emfcamp/badge-2024-hardware/pins-and-bom.ods

Sheet: Pin planning
Device | Configuration | Pin name | Pin number | Special functions | Initial state | Function | Section |  | Hexpansion pins | Function | SFP func |  |  | I2C Addr
ESP |  | 0 | 5 | Bootloader | ext pullup | BL | baseboard |  | 1 | GND | VeeT |  | bus id | BUS | Device | Address | Config | Notes
ESP |  | 1 | 6 |  |  | TOP_HS4 | top | display_cs | 2 | LS_1 | Tx_Fault |  | n/a | ESP | TCA9548PWR | 0x77 | A2/A1/A0=H | May not be used by other devices
ESP |  | 2 | 7 |  |  | TOP_HS3 | top | display_DC | 3 | LS_2 | Tx_Disable |  | BUS7 | SYSTEM | AW9523BTQR A | 0x58 | AD0=L, AD1=L
ESP |  | 3 | 8 |  |  | F_HS1 | F |  | 4 | SDA | SDA |  | BUS7 | SYSTEM | AW9523BTQR B | 0x59 | AD0=H, AD1=L
ESP |  | 4 | 9 |  |  | F_HS2 | F |  | 5 | SCL | SCL |  | BUS7 | SYSTEM | AW9523BTQR C | 0x5a | AD0=L, AD1=H
ESP |  | 5 | 10 |  |  | F_HS3 | F |  | 6 | NoduleDetect | Mod_ABS |  | BUS7 | SYSTEM | BQ25895RTWR | 0x6A | fixed
ESP |  | 6 | 11 |  |  | F_HS4 | F |  | 7 | LS_3 | RS0 |  | BUS7 | SYSTEM | FUSB302MPX | 0x22 | fixed
ESP |  | 7 | 12 |  |  | TOP_HS2 | top | display_data | 8 | LS_4 | Rx_LOS |  | BUS7 | SYSTEM | SC7A20TR | 0x18 | SDO=L
ESP |  | 8 | 13 |  |  | TOP_HS1 | top | display_clk | 9 | LS_5 | RS1 |  | BUS7 | SYSTEM | LSM6DS3TR-C | 0x6B | SDO=H
ESP |  | 9 | 14 |  |  | I2C_RESET | baseboard |  | 10 | GND | VeeR |  | BUS0 | TOP | FUSB302MPX | 0x22 | fixed | not allowed on top board
ESP |  | 10 | 15 |  |  | Interrupt | baseboard |  | 11 | GND | VeeR |  | BUS0 | TOP | ZD24C64A-XGMT | 0x57/0x5f | AD0/1/2=H | required for id/code
ESP |  | 11 | 16 |  |  | D_HS1 | D |  | 12 | HS_1 | RD- |  | BUS1-6 | hexpansion | ZD24C64A-XGMT | 0x57/0x5f | AD0/1/2=H | preferred for id/code
ESP |  | 12 | 17 |  |  | D_HS4 | D |  | 13 | HS_2 | RD+ |  | BUS1-6 | hexpansion | M24C16-RMN6TP | 0x50-0x57 | fixed | allowed for id/code
ESP |  | 13 | 18 |  |  | D_HS3 | D |  | 14 | GND | VeeR
ESP |  | 14 | 19 |  |  | D_HS2 | D |  | 15 | +3V3 | VccR
ESP |  | 15 | 21 |  |  | E_HS3 | E |  | 16 | +3V3 | VccT
ESP |  | 16 | 22 |  |  | E_HS2 | E |  | 17 | GND | VeeT
ESP |  | 17 | 23 |  |  | E_HS4 | E |  | 18 | HS_3 | TD+
ESP |  | 18 | 24 |  |  | E_HS1 | E |  | 19 | HS_4 | TD-
ESP |  | 19 | 25 | USB- |  | USB- | baseboard |  | 20 | GND | VeeT
ESP |  | 20 | 26 | USB+ |  | USB+ | baseboard
ESP |  | 21 | 27 |  |  | LED_DATA | top
ESP |  | 33 | 38 |  |  | C_HS2 | C
ESP |  | 34 | 39 |  |  | C_HS1 | C |  |  | FPC pins |  |  |  |  | SOICBITE pins
ESP |  | 35 | 40 |  |  | B_HS1 | B |  |  | Baseboard | Top | Function |  |  | 1 | GND
ESP |  | 36 | 41 |  |  | B_HS2 | B |  |  | 1 | 30 | GND |  |  | 2 | USB+
ESP |  | 37 | 42 |  |  | B_HS3 | B |  |  | 2 | 29 | LED_DATA |  |  | 3 | USB-
ESP |  | 38 | 43 |  |  | B_HS4 | B |  |  | 3 | 28 | VBAT_SW |  |  | 4 | VBUS
ESP |  | 39 | 44 | tck |  | A_HS1 | A |  |  | 4 | 27 | VBAT_SW |  |  | 5 | ESPRESET
ESP |  | 40 | 45 | tdo |  | A_HS2 | A |  |  | 5 | 26 | GND |  |  | 6 | BOOTLOADER
ESP |  | 41 | 47 | tdi |  | A_HS3 | A |  |  | 6 | 25 | BTN1 |  |  | 7 | ESP_RXD
ESP |  | 42 | 48 | tms |  | A_HS4 | A |  |  | 7 | 24 | BTN2 |  |  | 8 | ESP_TXD
ESP |  | 43 | 49 | TXD |  | TX | baseboard |  |  | 8 | 23 | BTN3
ESP |  | 44 | 50 | RXD |  | RX | baseboard |  |  | 9 | 22 | BTN4
ESP |  | 45 | 51 |  |  | SDA | baseboard |  |  | 10 | 21 | BTN5
ESP |  | 46 | 52 |  |  | SCL | baseboard |  |  | 11 | 20 | BTN6
ESP |  | 47 | 37 |  |  | C_HS3 | C |  |  | 12 | 19 | 3V3
ESP |  | 48 | 36 |  |  | C_HS4 | C |  |  | 13 | 18 | 3V3
 |  |  |  |  |  |  |  |  |  | 14 | 17 | GND
AW9523B A | AD0=L, AD1=L | P0_0 | 5 |  | 0 | DLS5 | D |  |  | 15 | 16 | GND
AW9523B A | AD0=L, AD1=L | P0_1 | 6 |  | 0 | INT_ACCEL | baseboard |  |  | 16 | 15 | TOP_HS1 | display_clk
AW9523B A | AD0=L, AD1=L | P0_2 | 7 |  | 0 | ELS1 | E |  |  | 17 | 14 | TOP_HS2 | display_data
AW9523B A | AD0=L, AD1=L | P0_3 | 8 |  | 0 | ELS2 | E |  |  | 18 | 13 | TOP_HS3 | display_dc
AW9523B A | AD0=L, AD1=L | P0_4 | 10 |  | 0 | ELS3 | E |  |  | 19 | 12 | TOP_HS4 | display_cs
AW9523B A | AD0=L, AD1=L | P0_5 | 11 |  | 0 | ELS4 | E |  |  | 20 | 11 | GND
AW9523B A | AD0=L, AD1=L | P0_6 | 12 |  | 0 | ELS5 | E |  |  | 21 | 10 | TOP_LS1
AW9523B A | AD0=L, AD1=L | P0_7 | 13 |  | 0 | FLS1 | F |  |  | 22 | 9 | TOP_LS2 | display_reset
AW9523B A | AD0=L, AD1=L | P1_0 | 1 |  | 0 | DLS1 | D |  |  | 23 | 8 | SDA
AW9523B A | AD0=L, AD1=L | P1_1 | 2 |  | 0 | DLS2 | D |  |  | 24 | 7 | SCL
AW9523B A | AD0=L, AD1=L | P1_2 | 3 |  | 0 | DLS3 | D |  |  | 25 | 6 | BOOTLOAD
AW9523B A | AD0=L, AD1=L | P1_3 | 4 |  | 0 | DLS4 | D |  |  | 26 | 5 | RESET
AW9523B A | AD0=L, AD1=L | P1_4 | 14 |  | 0 | FLS2 | F |  |  | 27 | 4 | TXOUT
AW9523B A | AD0=L, AD1=L | P1_5 | 15 |  | 0 | FLS3 | F |  |  | 28 | 3 | RXIN
AW9523B A | AD0=L, AD1=L | P1_6 | 16 |  | 0 | FLS4 | F |  |  | 29 | 2 | GND
AW9523B A | AD0=L, AD1=L | P1_7 | 17 |  | 0 | FLS5 | F |  |  | 30 | 1 | GND
AW9523B B | AD0=H, AD1=L | P0_0 | 5 |  | Hiz | BTN3 | top
AW9523B B | AD0=H, AD1=L | P0_1 | 6 |  | Hiz | BTN4 | top
AW9523B B | AD0=H, AD1=L | P0_2 | 7 |  | Hiz | BTN5 | top
AW9523B B | AD0=H, AD1=L | P0_3 | 8 |  | Hiz | BTN6 | top
AW9523B B | AD0=H, AD1=L | P0_4 | 10 |  | 0 | CLS1 | C
AW9523B B | AD0=H, AD1=L | P0_5 | 11 |  | 0 | CLS2 | C
AW9523B B | AD0=H, AD1=L | P0_6 | 12 |  | 0 | CLS3 | C
AW9523B B | AD0=H, AD1=L | P0_7 | 13 |  | 0 | CLS4 | C
AW9523B B | AD0=H, AD1=L | P1_0 | 1 |  | 1 | DET_C | C
AW9523B B | AD0=H, AD1=L | P1_1 | 2 |  | 1 | DET_D | D
AW9523B B | AD0=H, AD1=L | P1_2 | 3 |  | 1 | DET_E | E
AW9523B B | AD0=H, AD1=L | P1_3 | 4 |  | 1 | DET_F | F
AW9523B B | AD0=H, AD1=L | P1_4 | 14 |  | 0 | CLS5 | C
AW9523B B | AD0=H, AD1=L | P1_5 | 15 |  | 0 | BLS3 | B
AW9523B B | AD0=H, AD1=L | P1_6 | 16 |  | 0 | BLS4 | B
AW9523B B | AD0=H, AD1=L | P1_7 | 17 |  | 0 | BLS5 | B
AW9523B C | AD0=L, AD1=H | P0_0 | 5 |  | 0 | BLS1 | B
AW9523B C | AD0=L, AD1=H | P0_1 | 6 |  | 0 | BLS2 | B
AW9523B C | AD0=L, AD1=H | P0_2 | 7 |  | 0 | led_power_en | top
AW9523B C | AD0=L, AD1=H | P0_3 | 8 |  | 0 | ALS1 | A
AW9523B C | AD0=L, AD1=H | P0_4 | 10 |  | Hiz | PMID_SW | baseboard
AW9523B C | AD0=L, AD1=H | P0_5 | 11 |  | Hiz | USBSEL | baseboard
AW9523B C | AD0=L, AD1=H | P0_6 | 12 |  | Hiz | BTN1 | top
AW9523B C | AD0=L, AD1=H | P0_7 | 13 |  | Hiz | BTN2 | top
AW9523B C | AD0=L, AD1=H | P1_0 | 1 |  | 0 | ALS2 | A
AW9523B C | AD0=L, AD1=H | P1_1 | 2 |  | 0 | ALS3 | A
AW9523B C | AD0=L, AD1=H | P1_2 | 3 |  | 0 | ALS4 | A
AW9523B C | AD0=L, AD1=H | P1_3 | 4 |  | 0 | ALS5 | A
AW9523B C | AD0=L, AD1=H | P1_4 | 14 |  | 1 | DET_A | A
AW9523B C | AD0=L, AD1=H | P1_5 | 15 |  | 1 | DET_B | B
AW9523B C | AD0=L, AD1=H | P1_6 | 16 |  | 1 | TLS2 | top | display_reset
AW9523B C | AD0=L, AD1=H | P1_7 | 17 |  | 1 | TLS1 | top

Sheet: Part list and costings
LIN | PN | onb | Desc | Quantity | Cost at q3000 | EC unit | EC tot | Avail | URL
1 | ESP32-S3-PICO-1-N8R2 | x | MCU | 1 | 3.4 | 3.4 | 11900 | 1466 | https://www.digikey.de/en/products/detail/espressif-systems/ESP32-S3-PICO-1-N8R2/21264372
2 | AW9523BTQR | x | I/O exp | 3 | 0.27 | 0.81 | 2835 | 5000 | https://www.lcsc.com/product-detail/I-O-Expanders_AWINIC-Shanghai-Awinic-Tech-AW9523BTQR_C148077.html
3 | TCA9548PWR | x | i2c mux | 1 | 0.26 | 0.26 | 910 | 17000 | https://www.lcsc.com/product-detail/Signal-Switches-Encoders-Decoders-Multiplexers_Texas-Instruments-TCA9548APWR_C130026.html
4 | BQ25895RTWR | x | PMIC | 1 | 0.57 | 0.57 | 1995 | 5146 | https://www.lcsc.com/product-detail/span-style-background-color-ff0-Battery-span-Management-ICs_Texas-Instruments-BQ25895RTWR_C80200.html
5 | TYPE-C 16P CB1.6 073 | x | USB-C | 2 | 0.04 | 0.08 | 280 | 21000 | https://www.lcsc.com/product-detail/USB-Connectors_SHOU-HAN-TYPE-C-16P-CB1-6-073_C2906290.html
6 | TS24CA | x | Switch | 9 | 0.011 | 0.099 | 346.5 | 45000 | https://www.lcsc.com/product-detail/Tactile-Switches_SHOU-HAN-TS24CA_C393942.html
7 | MT9700 | x | load switch | 8 | 0.03 | 0.24 | 840 | 116000 | https://www.lcsc.com/product-detail/Power-Distribution-Switches_XI-AN-Aerosemi-Tech-MT9700_C89855.html
8 | SMTSO2030CTJ | x | SMD standoff M2x3 | 12 | 0.055 | 0.66 | 2310 | 1385 | https://www.lcsc.com/product-detail/SMD-round-nut_Sinhoo-SMTSO2030CTJ_C2915627.html
9 | SMTSO3030CTJ | x | SMD standoff M3x3 | 6 | 0.055 | 0.33 | 1155 | 9715 | https://www.lcsc.com/product-detail/SMD-round-nut_Sinhoo-SMTSO3030CTJ_C2915308.html
10 | HC-SFP-20P | x | SFP conns | 6 | 0.215 | 1.29 | 4515 | 5885 | https://www.lcsc.com/product-detail/Card-Edge-Connectors_HCTL-HC-SFP-20P_C2897291.html
11 | TLV62595DMQR | x | DC/DC | 1 | 0.18 | 0.18 | 630 | 3310 | https://www.lcsc.com/product-detail/DC-DC-Converters_Texas-Instruments-TLV62595DMQR_C3189969.html
12 | FTC252010SR47MBCA | x | Inductor DC/DC | 1 | 0.022 | 0.022 | 77 | 4700 | https://www.lcsc.com/product-detail/Power-Inductors_cjiang-Changjiang-Microelectronics-Tech-FTC252010SR47MBCA_C5832354.html
13 | SK6805SIDE-S | x | RGB LED side | 12 | 0.113 | 1.356 | 4746 | 2505 | https://www.lcsc.com/product-detail/Light-Emitting-Diodes-LED_OPSCO-Optoelectronics-SK6805SIDE-S_C2909057.html
14 | SK6805MICRO-J | x | RGB LED | 7 | 0.09 | 0.63 | 2205 | 4290 | https://www.lcsc.com/product-detail/Light-Emitting-Diodes-LED_OPSCO-Optoelectronics-SK6805MICRO-J_C2909056.html
15 | ZD24C64A-XGMT | x | i2c eeprom | 1 | 0.08 | 0.08 | 280 | 25000 | https://www.lcsc.com/product-detail/EEPROM_Zetta-ZD24C64A-XGMT_C2875852.html
16 |  | x | M3*10+3mm standoff | 6 | 0.021 | 0.126 | 441 | 2680 | https://www.lcsc.com/product-detail/Single-ended-hex-stud_Made-in-China-M3-10-3_C139813.html
17 | 3x6 |  | M3x6 screw | 6 | 0.0016 | 0.0096 | 33.6 | 20000 | https://www.lcsc.com/product-detail/phillips-pan-head-machine-screws_Made-in-China-3x6_C50053.html
18 | PM2x4 |  | M2x4 screw | 12 | 0.0015 | 0.018 | 63 | 13000 | https://www.lcsc.com/product-detail/phillips-pan-head-machine-screws_Shuntian-PM2X4_C357533.html
19 | 2450AT07A0100 | x | Antenna | 1 | 0.28 | 0.28 | 980 | 83000 | https://www.digikey.de/en/products/detail/2450AT07A0100001T/712-2450AT07A0100001TCT-ND/4770713?curr=usd
20 | SN74LVC1G04DCKR | x | inverter | 6 | 0.02 | 0.12 | 420 | 177000 | https://www.lcsc.com/product-detail/Inverters_UMW-Youtai-Semiconductor-Co-Ltd-SN74LVC1G04DCKR_C2983744.html
21 | XL-1608SURC-06 | x | charge indicator led | 2 | 0.002 | 0.004 | 14 | 2000000 | https://www.lcsc.com/product-detail/Light-Emitting-Diodes-LED_XINGLIGHT-XL-1608SURC-06_C965799.html
22 | 74LVC1G17GW,125 | x | level shift buffer | 1 | 0.046 | 0.046 | 161 | 2390 | https://www.lcsc.com/product-detail/Buffer-Driver-Transceiver_Nexperia-74LVC1G17GW-125_C426705.html
23 | AFC01-S30FCC-00 | x | ribbon connector | 2 | 0.08 | 0.16 | 560 | 10556 | https://www.lcsc.com/product-detail/FFC-FPC-Connectors_JUSHUO-AFC01-S30FCC-00_C262279.html
24 | JS05B-30P-100-4-8 |  | ribbon cable | 1 | 0.05 | 0.05 | 175 | 3880 | https://www.lcsc.com/product-detail/FFC-FPC-Connect-Cables_JUSHUO-JS05B-30P-100-4-8_C2857736.html
25 | B2B-PH-SM4-TB(LF)(SN) | x | battery connector | 1 | 0.08 | 0.08 | 280 | 255000 | https://www.lcsc.com/product-detail/Wire-To-Board-Wire-To-Wire-Connector_JST-B2B-PH-SM4-TB-LF-SN_C160352.html
26 | SC7A20TR | x | accelerometer | 0 | 0.13 | 0 | 0 | 9712 | https://www.lcsc.com/product-detail/Attitude-Sensor-Gyroscope_Hangzhou-Silan-Microelectronics-SC7A20TR_C5126709.html
27 | LSM6DS3TR-C | x | accelerometer+gyro | 1 | 0.59 | 0.59 | 2065 | 19800 | https://www.lcsc.com/product-detail/Attitude-Sensor-Gyroscope_STMicroelectronics-LSM6DS3TR-C_C967633.html
28 |  | x | 5k1 | 0 | 0.0005 | 0 | 0
29 | RC0402FR-0711K3L | x | 11k3 | 8 | 0.0005 | 0.004 | 14 | 23900 | https://www.lcsc.com/product-detail/Chip-Resistor-Surface-Mount_YAGEO-RC0402FR-0711K3L_C189473.html
30 | RC0402FR-07100KL | x | 100k | 6 | 0.0005 | 0.003 | 10.5 | 3700000 | https://www.lcsc.com/product-detail/Chip-Resistor-Surface-Mount_YAGEO-RC0402FR-07100KL_C60491.html
31 | RC0402FR-0710KL | x | 10k | 15 | 0.0005 | 0.0075 | 26.25 | 7190000 | https://www.lcsc.com/product-detail/Chip-Resistor-Surface-Mount_YAGEO-RC0402FR-0710KL_C60490.html
32 | RC0402FR-071KL | x | 1k | 5 | 0.0005 | 0.0025 | 8.75 | 2080000 | https://www.lcsc.com/product-detail/Chip-Resistor-Surface-Mount_YAGEO-RC0402FR-071KL_C106235.html
33 | RC0402FR-072K2L | x | 2k2 | 7 | 0.0005 | 0.0035 | 12.25 | 933000 | https://www.lcsc.com/product-detail/Chip-Resistor-Surface-Mount_YAGEO-RC0402FR-072K2L_C114762.html
34 | RC0402FR-0745K3L | x | 45k3 | 1 | 0.0005 | 0.0005 | 1.75 | 191598 | https://www.lcsc.com/product-detail/Chip-Resistor-Surface-Mount_YAGEO-RC0402FR-0745K3L_C137977.html
35 | RC0402FR-07261RL | x | 261R | 1 | 0.0005 | 0.0005 | 1.75 | 28300 | https://www.lcsc.com/product-detail/Chip-Resistor-Surface-Mount_YAGEO-RC0402FR-07261RL_C273335.html
36 | RC0402FR-074K3L | x | 4k3 | 1 | 0.0005 | 0.0005 | 1.75 | 59700 | https://www.lcsc.com/product-detail/Chip-Resistor-Surface-Mount_YAGEO-RC0402FR-074K3L_C477725.html
37 | RCLAMP0524P-ES | x | esd protection | 25 | 0.02 | 0.5 | 1750 | 41000 | https://www.lcsc.com/product-detail/ESD-Protection-Devices_ElecSuper-RCLAMP0524P-ES_C5180236.html
38 | TS3USB221ARSER | x | USB mux | 1 | 0.19 | 0.19 | 665 | 27000 | https://www.lcsc.com/product-detail/Analog-Switches-Special-Purpose_Texas-Instruments-TS3USB221ARSER_C128396.html
39 | YHNR4020-2R2M | x | Inductor charge controller | 1 | 0.05 | 0.05 | 175 | 16800 | https://www.lcsc.com/product-detail/Power-Inductors_YJYCOIN-YHNR4020-2R2M_C2926400.html
40 | CL31A226KOHNNNE | x | 22uF 1206 cap 16V X5R | 1 | 0.02 | 0.02 | 70 | 800000 | https://www.lcsc.com/product-detail/Multilayer-Ceramic-Capacitors-MLCC-SMD-SMT_Samsung-Electro-Mechanics-CL31A226KOHNNNE_C90146.html
41 | CL31B106KAHNNNE | x | 10uF 1206 cap 25V X7R | 28 | 0.013 | 0.364 | 1274 | 580000 | https://www.lcsc.com/product-detail/Multilayer-Ceramic-Capacitors-MLCC-SMD-SMT_Samsung-Electro-Mechanics-CL31B106KAHNNNE_C14860.html
42 | CL10A475KA8NQNC | x | 4.7uF 0603 cap 25V X5R | 1 | 0.01 | 0.01 | 35 | 1081000 | https://www.lcsc.com/product-detail/Multilayer-Ceramic-Capacitors-MLCC-SMD-SMT_Samsung-Electro-Mechanics-CL10A475KA8NQNC_C69335.html
43 | CL10A105KB8NNNC | x | 1uF 0603 cap | 12 | 0.004 | 0.048 | 168 | 3500000 | https://www.lcsc.com/product-detail/Multilayer-Ceramic-Capacitors-MLCC-SMD-SMT_Samsung-Electro-Mechanics-CL10A105KB8NNNC_C15849.html
44 | 0402B104K500NT | x | 100nF 0402 cap | 15 | 0.001 | 0.015 | 52.5 | 3060000 | https://www.lcsc.com/product-detail/Multilayer-Ceramic-Capacitors-MLCC-SMD-SMT_FH-Guangdong-Fenghua-Advanced-Tech-0402B104K500NT_C110251.html
45 | CC0402KRX7R9BB473 | x | 47nF 0402 cap | 1 | 0.0015 | 0.0015 | 5.25 | 1219000 | https://www.lcsc.com/product-detail/Multilayer-Ceramic-Capacitors-MLCC-SMD-SMT_YAGEO-CC0402KRX7R9BB473_C272875.html
46 | CC0402JRNPO9BN121 | x | 120pF | 1 | 0.0016 | 0.0016 | 5.6 | 106500 | https://www.lcsc.com/product-detail/Multilayer-Ceramic-Capacitors-MLCC-SMD-SMT_YAGEO-CC0402JRNPO9BN121_C106996.html
47 | FUSB302MPX | x | PD interface IC | 2 | 0.353 | 0.706 | 2471 | 21402 | https://www.lcsc.com/product-detail/span-style-background-color-ff0-USB-span-ICs_onsemi-Fusb302mpx_C442699.html
 |  |  |  |  |  | 13.4187 | 46965.45
extras:
 |  |  | screen |  | 4
 |  |  | battery |  | 4?
 |  |  | cable |  | 2?
 |  |  | pcbs |  | 1.7
 |  |  | assembly |  | ?
