emfcamp/badge-2024-hardware/tildagon-2026/spaceagon-bom.xlsx

Touch board
LIN | RD | Count | Value | MN | MPN | DN | DPN | Notes
1 | C1 | 1 | 100nF 50V X5R 0402
2 | C2 | 1 | 2.2nF 50V X5R 0402
3 | C11 | 1 | 1uF 50V X5R 0402
4 | R1-R16 | 16 | 560R 1% 0402
5 | U1 | 1 | CY8CMBR3116 | Cypress/Infineon | CY8CMBR3116-LQXIT | LCSC | C914913
6 | H1-H3 | 3 | M3x4 | Sinhoo | SMTSO3040CTJ | LCSC | C2915635
7 | J1 | 1 | PZ254-2-03-S-2.5-G0-R | HCTL | PZ254-2-03-S-2.5-G0-R | LCSC | C47355649
 | PCB | 1
 | Assembly | 1
Mid board
LIN | RD | Count | Value | MN | MPN | DN | DPN
1 | C1-C13 | 13 | 1uF 50V X5R 0402
2 | D1-D18 | 18 | SK6805MICRO-J | OPSCO | SK6805MICRO-J | LCSC | C2909056
3 | J1 | 1 | AFC01-S30FCA-00 | Jushuo | AFC01-S30FCA-00 | LCSC | C262671
4 | R1-R13 | 13 | 100k 1% 0402
5 | R14 | 1 | 1k 1% 0402
6 | U2 | 1 | AW9523B | AWINIC | AW9523BTQR | LCSC | C148077
7 | U3 | 1 | ZD24C64A | Zetta | ZD24C64A-XGMT | LCSC | C2875852
8 | U4 | 1 | 74LVC1G175 | TI | SN74LVC1G175DCKR | LCSC | C202238 | sponsored
9 | U5 | 1 | K1-5202UA-02 | Korean Hroparts Elec | K1-5202UA-02 | LCSC | C145900
10 | U6 | 1 | QMC6309 | QST | QMC6309 | LCSC | C5439871
11 | SW1-SW6 | 6 | TS-1101S-B-D-B-B-A | XKB | TS-1101S-B-D-B-B-A | LCSC | C609858
12
 | PCB | 1
 | Assembly | 1
