emfcamp/badge-2024-hardware/tildagon-2026/tildagon-2026-mid/3d/joystick.stp

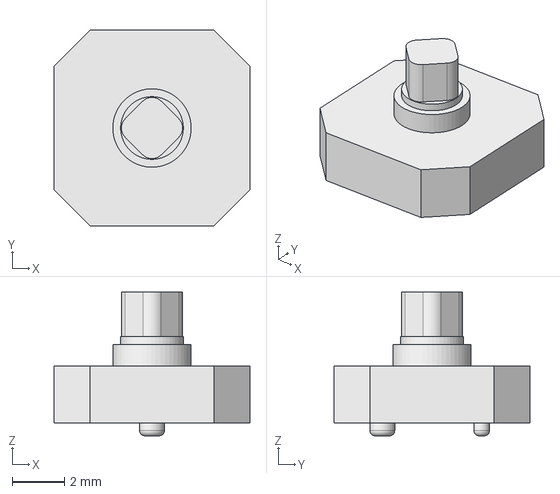
[picture p1: CAD file, 2026-07-23]
tildagon-2026/tildagon-2026-mid/3d/joystick.stp
7.50 x 7.50 x 5.50 mm
