emfcamp/badge-2024-hardware/tildagon-base/3d/B2B_PH_SM4_TB/B2B-PH-SM4-TB.step

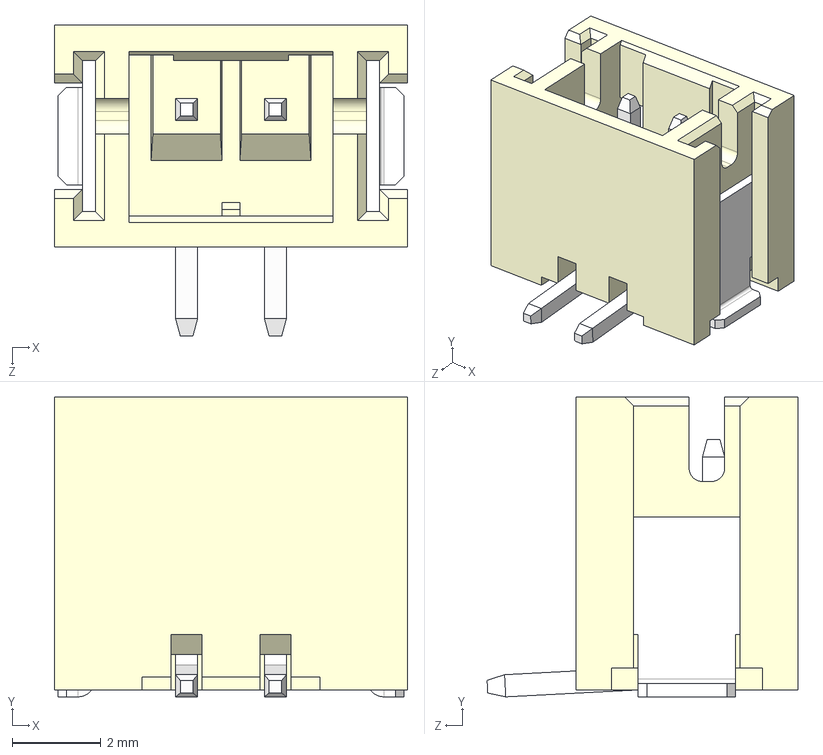
[picture p2: CAD file, 2023-12-13]
tildagon-base/3d/B2B_PH_SM4_TB/B2B-PH-SM4-TB.step
7.95 x 6.75 x 7.00 mm
