emfcamp/badge-2024-hardware/tildagon-2026/tildagon-2026-mid/3d/TS-1101S-B-D-B-B-A.step

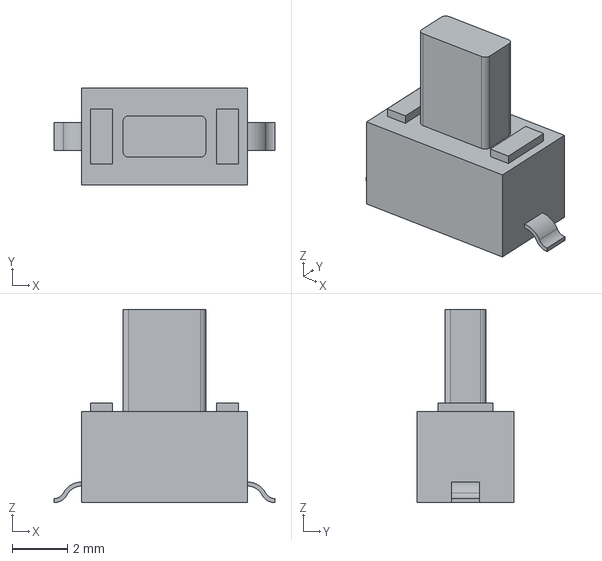
[picture p3: CAD file, 2026-07-23]
tildagon-2026/tildagon-2026-mid/3d/TS-1101S-B-D-B-B-A.step
8.00 x 3.50 x 7.00 mm
