emfcamp/badge-2024-hardware/tildagon-base/3d/hexpansion.step

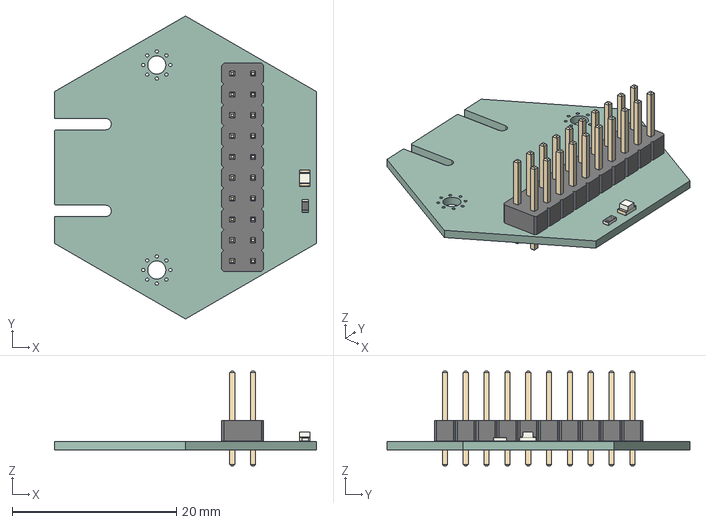
[picture p4: CAD file, 2024-03-15]
tildagon-base/3d/hexpansion.step
32.0 x 37.0 x 11.5 mm
hexpansion PCB
