emfcamp/badge-2024-hardware/tildagon-2026/tildagon-2026-mid/3d/SK6805MICRO-J.step

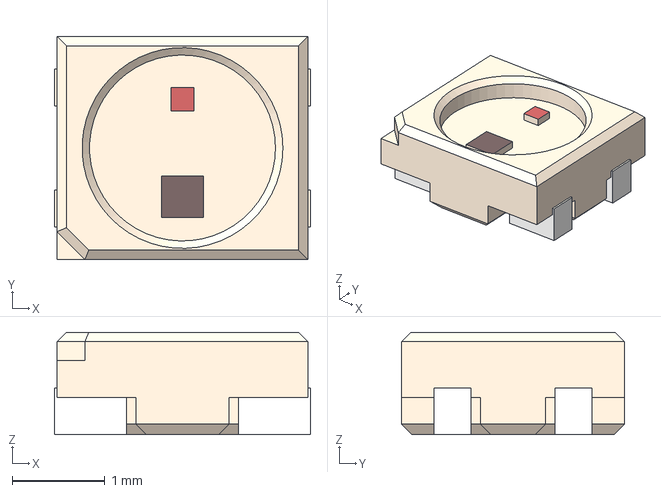
[picture p5: CAD file, 2023-12-13]
tildagon-2026/tildagon-2026-mid/3d/SK6805MICRO-J.step
2.75 x 2.40 x 1.10 mm
