emfcamp/badge-2024-hardware/tildagon-base/3d/24AT07A0100.step

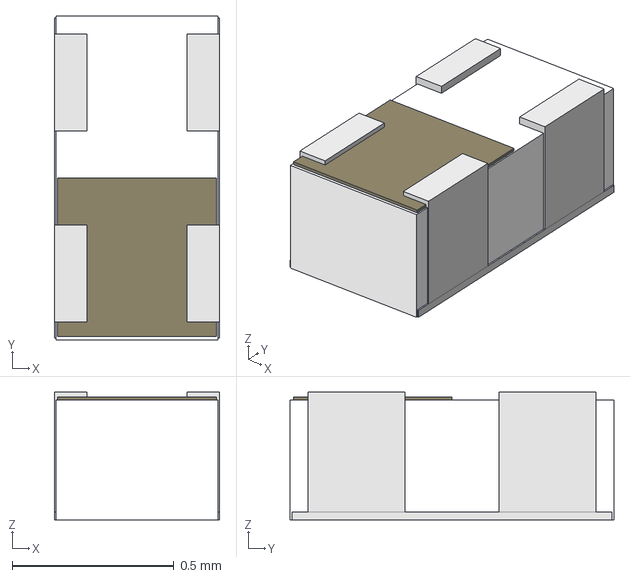
[picture p6: CAD file, 2023-12-13]
tildagon-base/3d/24AT07A0100.step
0.51 x 1.00 x 0.395 mm
