emfcamp/badge-2024-hardware/tildagon-2026/tildagon-2026-mid/3d/SK6805SIDE-S.step

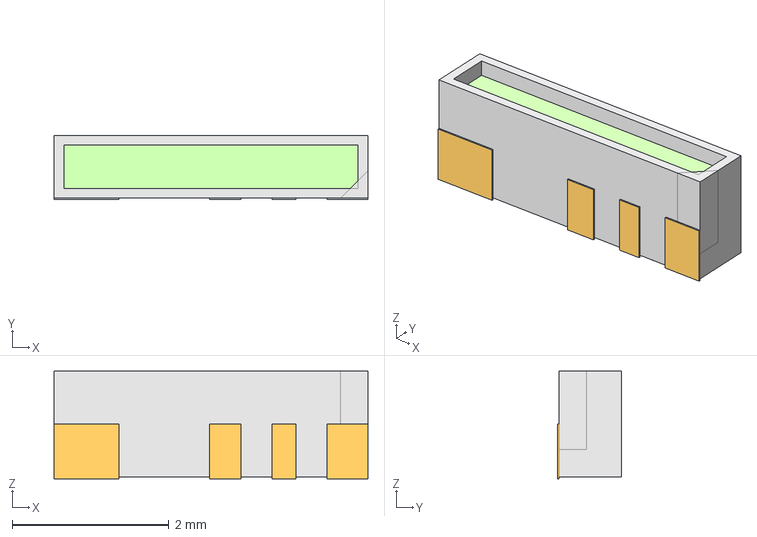
[picture p7: CAD file, 2023-12-08]
tildagon-2026/tildagon-2026-mid/3d/SK6805SIDE-S.step
4.00 x 0.82 x 1.38 mm
