emfcamp/badge-2024-hardware/tildagon-base/3d/SMTSO.FCStd

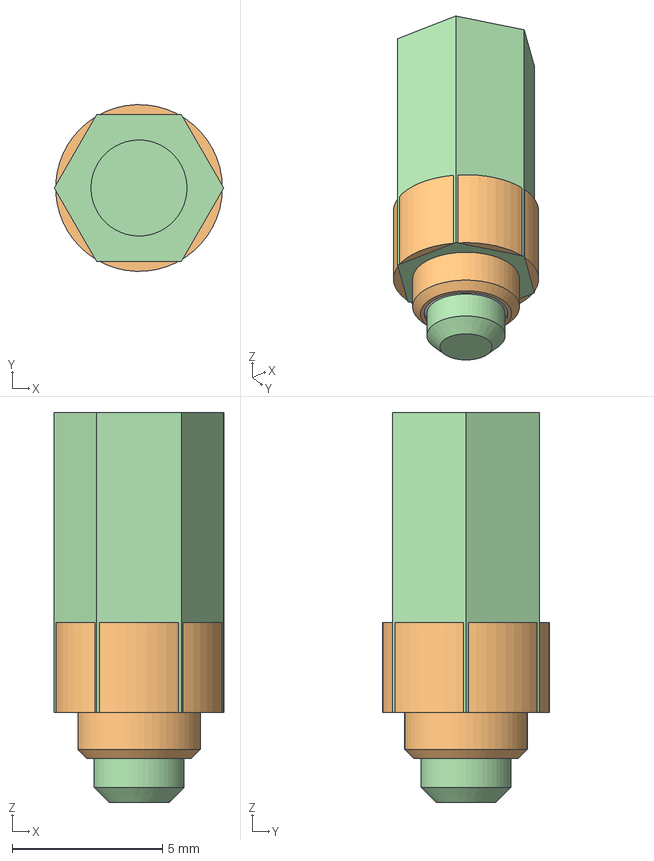
[picture p8: CAD file, 2023-12-13]
tildagon-base/3d/SMTSO.FCStd
5.65 x 5.56 x 13.0 mm
SMTSO2030
SMTSO3030
hexM3x8+3
hexM3x10+3
