emfcamp/badge-2024-hardware/tildagon-2026/tildagon-2026-mid/3d/display.step

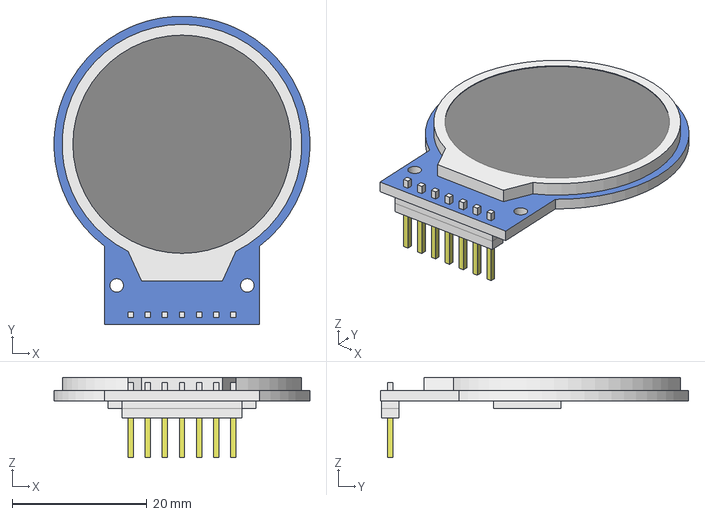
[picture p9: CAD file, 2023-11-27]
tildagon-2026/tildagon-2026-mid/3d/display.step
38.0 x 45.8 x 11.9 mm
