emfcamp/badge-2024-hardware/tildagon-base/3d/PUQFN-10.step

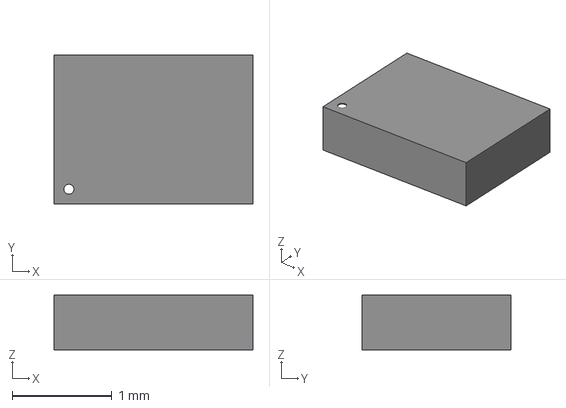
[picture p10: CAD file, 2023-12-13]
tildagon-base/3d/PUQFN-10.step
2.00 x 1.50 x 0.55 mm
