emfcamp/badge-2024-hardware/tildagon-base/3d/UFDN-10.step

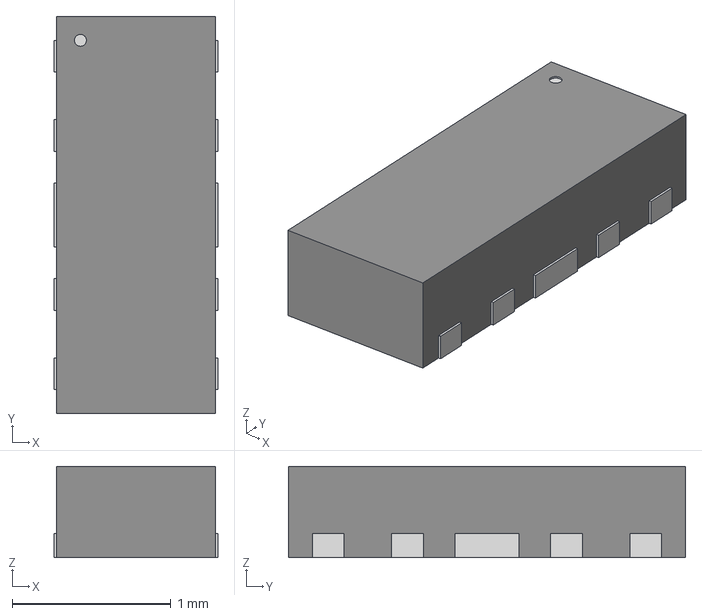
[picture p11: CAD file, 2023-12-13]
tildagon-base/3d/UFDN-10.step
1.03 x 2.50 x 0.575 mm
