emfcamp/badge-2024-hardware/tildagon-base/3d/hexM3x10+3.step

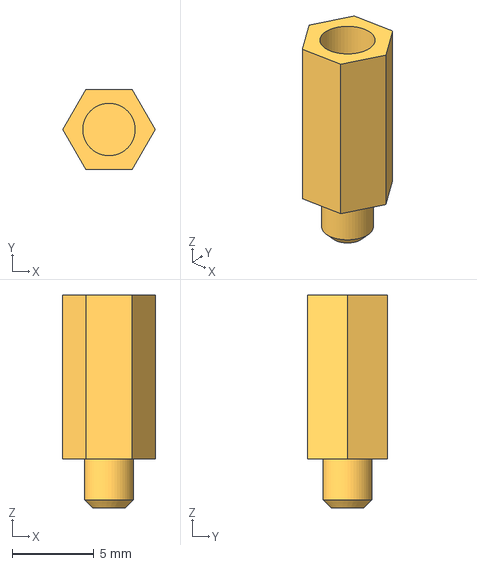
[picture p12: CAD file, 2023-12-13]
tildagon-base/3d/hexM3x10+3.step
5.65 x 4.89 x 13.0 mm
