emfcamp/badge-2024-hardware/tildagon-base/3d/SMTSO3030.step

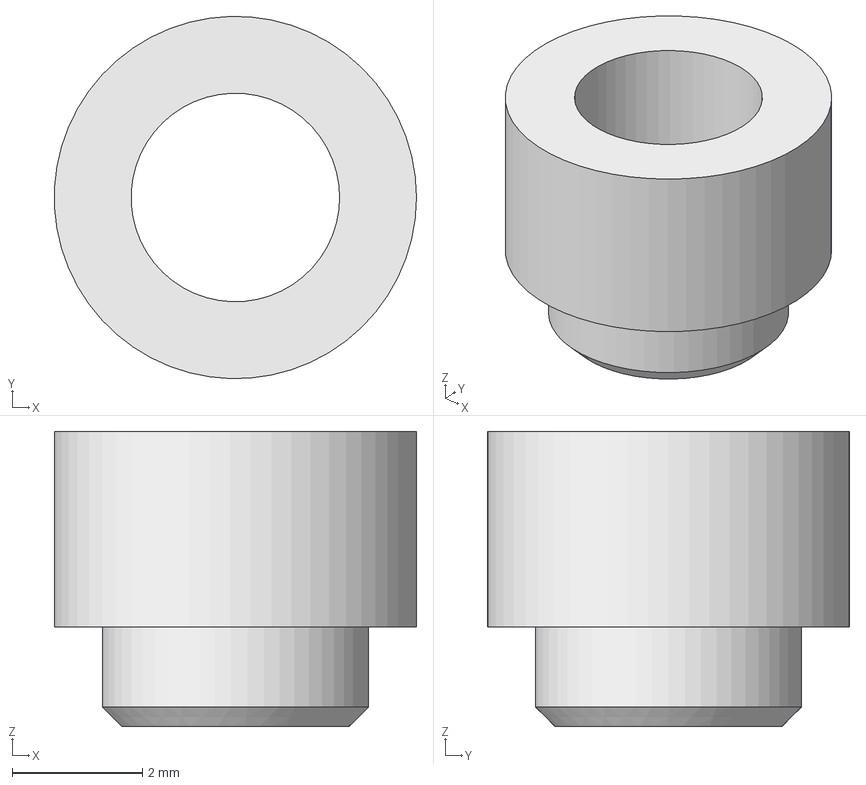
[picture p13: CAD file, 2023-12-09]
tildagon-base/3d/SMTSO3030.step
5.56 x 5.56 x 4.53 mm
