emfcamp/badge-2024-hardware/tildagon-base/3d/hexM3x8+3.step

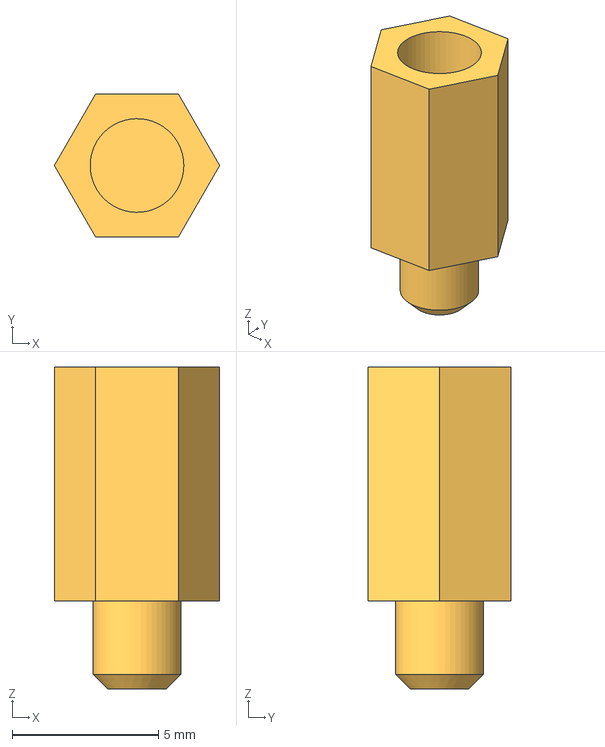
[picture p14: CAD file, 2023-12-09]
tildagon-base/3d/hexM3x8+3.step
5.65 x 4.89 x 11.0 mm
