emfcamp/badge-2024-hardware/tildagon-base/3d/SMTSO2030.step

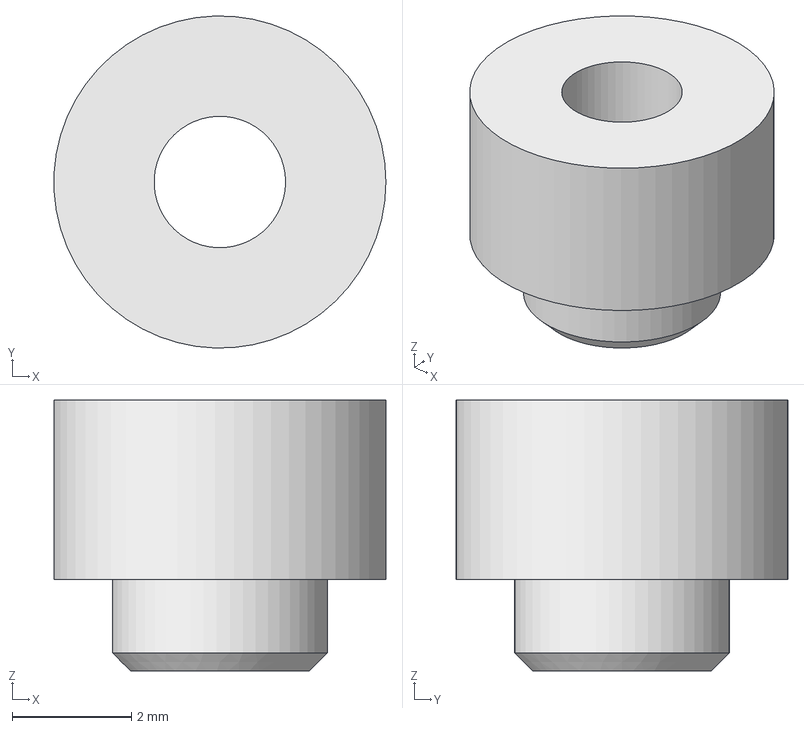
[picture p15: CAD file, 2023-12-09]
tildagon-base/3d/SMTSO2030.step
5.56 x 5.56 x 4.53 mm
