emfcamp/badge-2024-hardware/tildagon-base/3d/standoff-m3-12mm.step

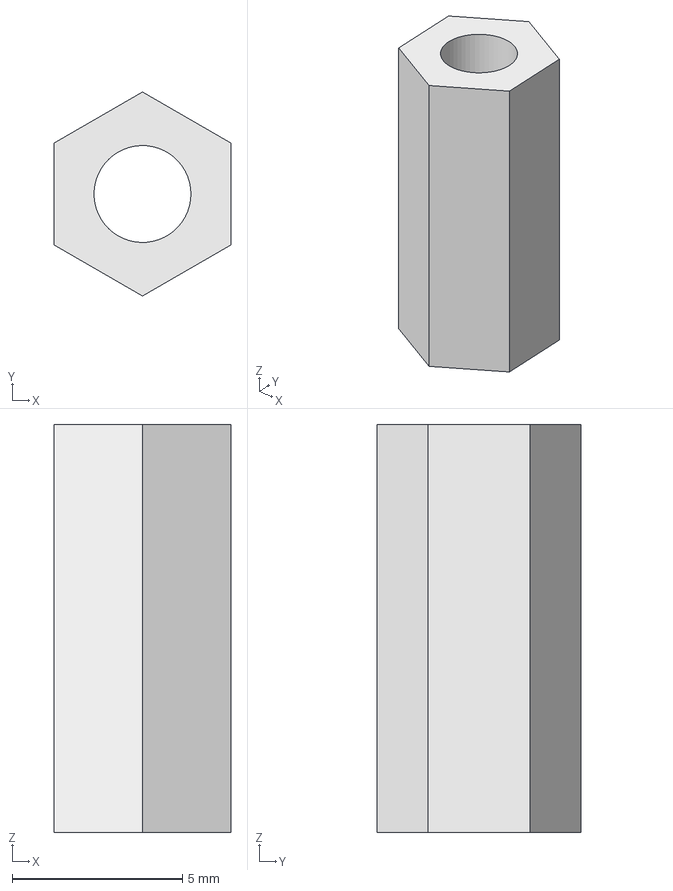
[picture p16: CAD file, 2023-11-27]
tildagon-base/3d/standoff-m3-12mm.step
5.20 x 6.00 x 12.0 mm
