emfcamp/badge-2024-hardware/tildagon-base/3d/SK68xx-EC3210F.step

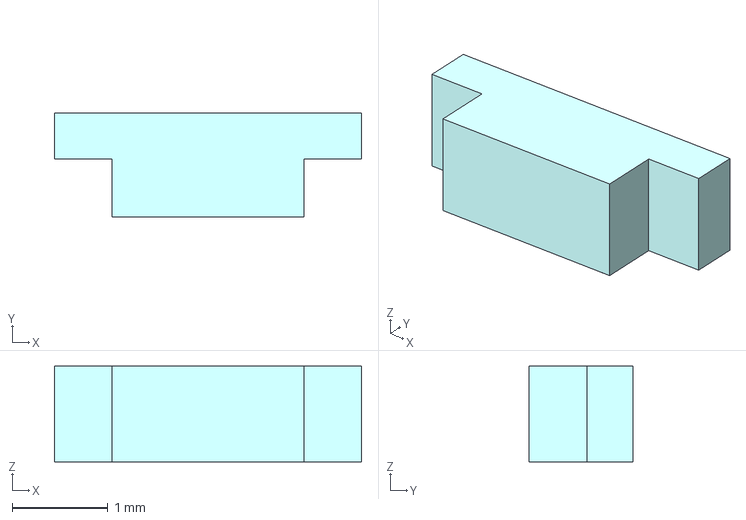
[picture p17: CAD file, 2023-11-27]
tildagon-base/3d/SK68xx-EC3210F.step
3.20 x 1.08 x 1.00 mm
