emfcamp/badge-2024-hardware/tildagon-base/3d/UE75-A20-6000T.step

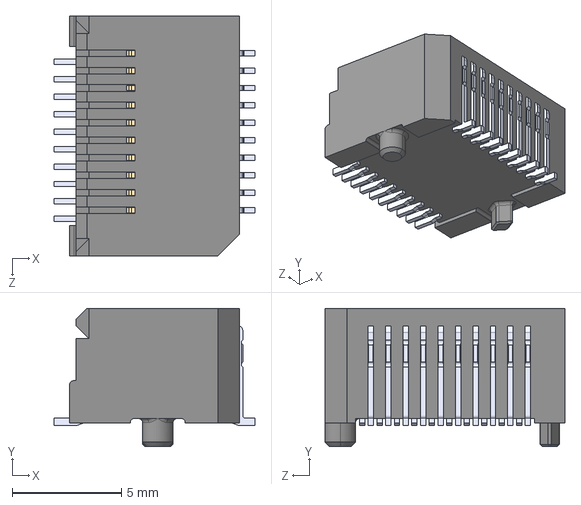
[picture p18: CAD file, 2023-11-27]
tildagon-base/3d/UE75-A20-6000T.step
9.20 x 6.33 x 11.0 mm
