emfcamp/badge-2024-hardware/tildagon-base/3d/hexpansion-base-shape.dxf

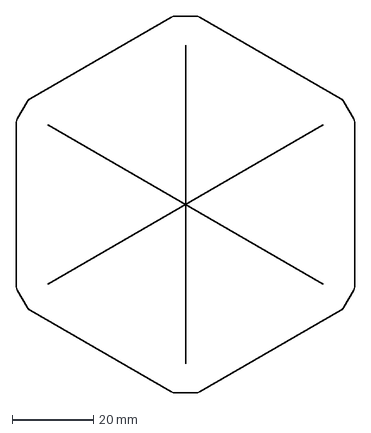
[picture p19: CAD file, 2023-11-27]
tildagon-base/3d/hexpansion-base-shape.dxf
83.1 x 92.5 mm
