emfcamp/badge-2024-hardware/tildagon-base/3d/1TS003B.step

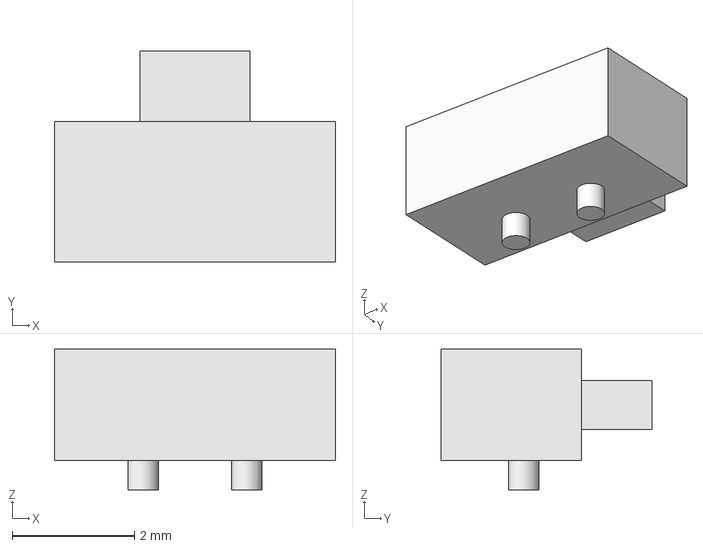
[picture p20: CAD file, 2023-11-27]
tildagon-base/3d/1TS003B.step
4.60 x 3.45 x 2.30 mm
