emfcamp/badge-2024-hardware/tildagon-base/3d/battery.step

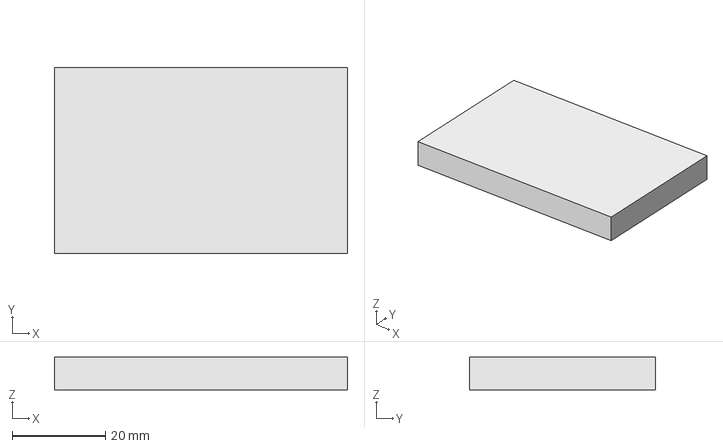
[picture p21: CAD file, 2023-11-27]
tildagon-base/3d/battery.step
63.0 x 40.0 x 7.00 mm
