emfcamp/badge-2024-hardware/(list of files, cad)

Other CAD files:
tildagon-base/3d/miscmodels.FCStd
tildagon-base/3d/sk6805side-s.FCStd
tildagon-base/3d/screen.FCStd
tildagon-base/3d/2169900003.stp
tildagon-base/3d/sk68xx-ec3210f.FCStd
