emfcamp/badge-2024-hardware/(threads)

Thread 1 (2024-03-18):

Accelerometer and Gyroscope datasheet is not included (LSM6D53)

Molive-0, 2024-03-18:
The datasheets for most chips on the board are included in the datasheets directory, but the datasheet for the accelerometer is not. The datasheet for an SC7A20 is included, but this is not what is listed on the schematic anymore, instead replaced with an LSM6D53.

Could the LSM6D53 datasheet be included?

Thread 5 (2024-03-19):

Hexpansion Example

egelmex, 2024-03-19:
Would it be useful in the user notes layer for the PCB to include a line showing the cut off between the area covered by the top plate and the area outside this?

kliment, 2024-03-19:
Possibly - though it's exactly the centerline between the two hexagon points.

egelmex, 2024-03-19:
Ah thanks, wasn't clear from this picture [Hexpansion](https://tildagon.badge.emfcamp.org/technical-reference/hexpansions/). Are there any technical drawing of the dimension etc that I have failed to find to work from?

kliment, 2024-03-19:
No, we're literally writing docs right this second. Have a dimensioned drawing to start with:

https://pads.orga.emfcamp.org/uploads/b456ffb9-f5bf-4387-b8ec-fd9796ad957b.png

egelmex, 2024-03-19:
amazing thank you.

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

kliment, 2024-03-20:
Relevant information is now at https://tildagon.badge.emfcamp.org/technical-reference/hexpansions/

kliment, 2024-03-20:
The template is also now updated.

egelmex, 2024-03-20:
Thanks Kilment, the documenation looks great.

Closed 2024-03-20.

Thread 9 (2024-04-22):

Hexpansion STEP file does not match documentation.

gsuberland, 2024-04-22:
The [Hexpansion STEP 3D model](https://github.com/emfcamp/badge-2024-hardware/blob/main/tildagon-base/3d/hexpansion.step) does not match the mechanical drawing from the [documentation](https://tildagon.badge.emfcamp.org/technical-reference/hexpansions/).

The drawing shows the tab sticking out of the hexagon, forming a 14.25mm distance from the mounting hole axis:

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

The STEP file, on the other hand, has the tab flush with the hexagon edge, forming a 12.50mm distance from the mounting hole axis.

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

Given that the KiCad project appears to match the mechanical drawing, my guess is that the STEP model is outdated and needs to be replaced.

gsuberland, 2024-04-22:
In addition it looks like there's a small error in the mechanical drawing, since the lines are marked as being separated by 3.525mm, but 17.5mm minus 14.25mm is 3.5mm.

thinkl33t, 2024-05-13:
Ah, the step file is from the original version of the hexpansion, which had the connector flush.

We'll get this updated :)

Thread 12 (2024-06-05):

Add pin 1 and pin 11 identification to documentation

AndyKirby, 2024-06-05:
Guys

I picked up a tildagon and a hexpansion board at EMF 2024 but unfortunately the hexpansion will not power up, I have traced this back to there being no ident pin to ground connection but am struggling to identify the ident pin (ironic huh) with any confidence.

https://tildagon.badge.emfcamp.org/hexpansions/creating-hexpansions/#connectors

Gives the pinout and which Top/Bottom side of the board, but omits a way to identify which way around (connector towards/away from the viewer) the board needs to be and which end to count from.

I would use the schematic and docs but the version of kicad with my distro refuses to work with the files as they are from a newer version of kicad. A PDF version of the Hexpansion and Tildagon schematics added to the repository and maybe similar for the PCB's would be really helpful for reference purposes and reduce the yak shaving when fixing/hacking existing boards.

Thanks for the work so far it is great to be moving towards re-usability.

kliment, 2024-06-05:
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

I've marked the ident pin on this image with some silkscreen. Hope this helps!

AndyKirby, 2024-06-05:
Thanks guys

That will do it.

BTW is there a place I can order a couple of the breakout boards from. I
am currently musing on prototyping a board or two for next EMF and could
do with buying a couple.

Maybe like the PCBWay (other board houses are applicable) shared
projects, or even just someone selling them somewhere.

Cheers

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

--
***@***.***
www.kirbyand.co.uk

octachrome, 2024-10-26:
If you're still looking, you can buy a breakout board here: https://www.tindie.com/products/gjchester/emf-badge-interposer-hexpansion/

I bought one a few weeks back, haven't tried it yet.

AndyKirby, 2024-10-26:
Awesome thnx will give one a try.

Cheers

Kirbs

26 Oct 2024 09:21:37 Chris Brown ***@***.***>:

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
