emfcamp/badge-2024-hardware/tildagon-base/tildagon-base.pdf

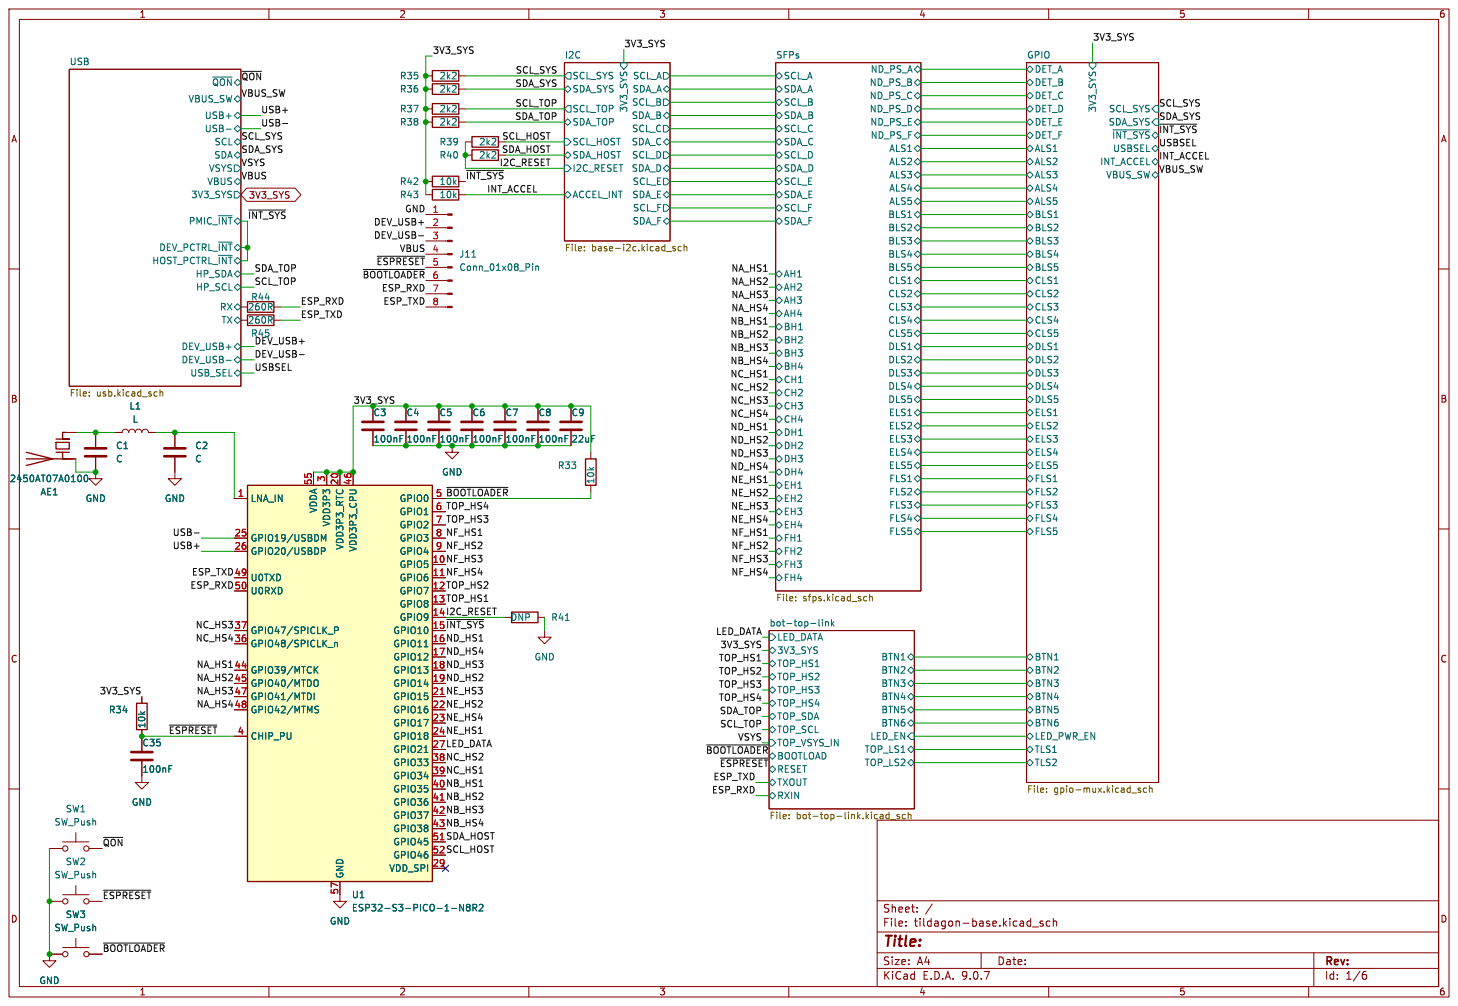
[picture p22: page 1]

3V3_SYS DEV_USB-
USB- USB+ SCL ~{QON} SDA
VBUS DEV_USB+ DEV_USB- USB_SEL VBUS_SW

Id: 1/6 Title: File: tildagon-base.kicad_sch Sheet: /

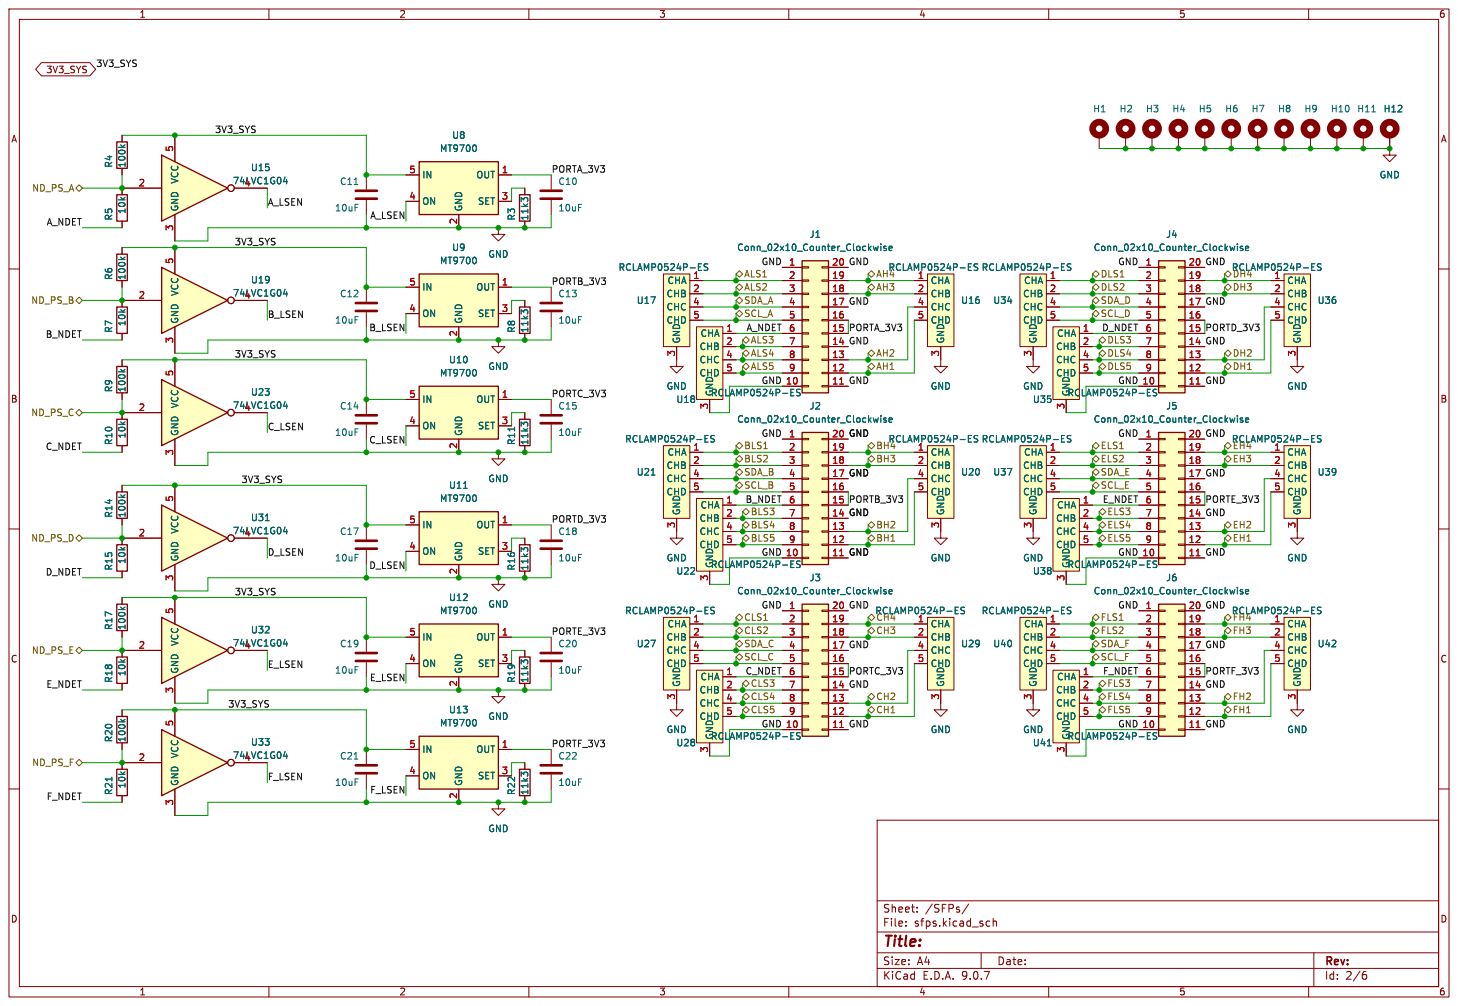
[picture p23: page 2]

H12 U17 RCLAMP0524P-ES CHA 1 CHB 2 CHC 4 CHD 5 GND

H12 CHA 1 CHB 2 CHC 4 CHD 5 GND

J4 Conn_02x10_Counter_Clockwise CHA 1 CHB 2 CHC 4 CHD 5 GND
ALS4 ALS5 ALS1 SDA_A
CHA 1 CHB 2 CHC 4 CHD 5 GND

U34 RCLAMP0524P-ES CHA 1 CHB 2 CHC 4 CHD 5 GND

3 U35 RCLAMP0524P-ES CHA 1 CHB 2 CHC 4 CHD 5 GND

11 U21 RCLAMP0524P-ES CHA 1 CHB 2 CHC 4 CHD 5 GND

3 U37 RCLAMP0524P-ES CHA 1 CHB 2 CHC 4 CHD 5 GND

3 U21 RCLAMP0524P-ES CHA 1 CHB 2 CHC 4 CHD 5 GND

3 U20 RCLAMP0524P-ES CHA 1 CHB 2 CHC 4 CHD 5 GND

2 OUT 1 SET 3 U11 MT9700 GND R16 11k3 CHA 1 CHB 2 CHC 4 CHD 5 GND

3 U38 RCLAMP0524P-ES CHA 1 CHB 2 CHC 4 CHD 5 GND

3 U28 RCLAMP0524P-ES CHA 1 CHB 2 CHC 4 CHD 5 GND

2 OUT 1 SET 3 U12 MT9700 GND GND

2 OUT 1 SET 3 GND GND GND U13 MT9700

3 U29 RCLAMP0524P-ES CHA 1 CHB 2 CHC 4 CHD 5 GND

3 U40 RCLAMP0524P-ES CHA 1 CHB 2 CHC 4 CHD 5 GND

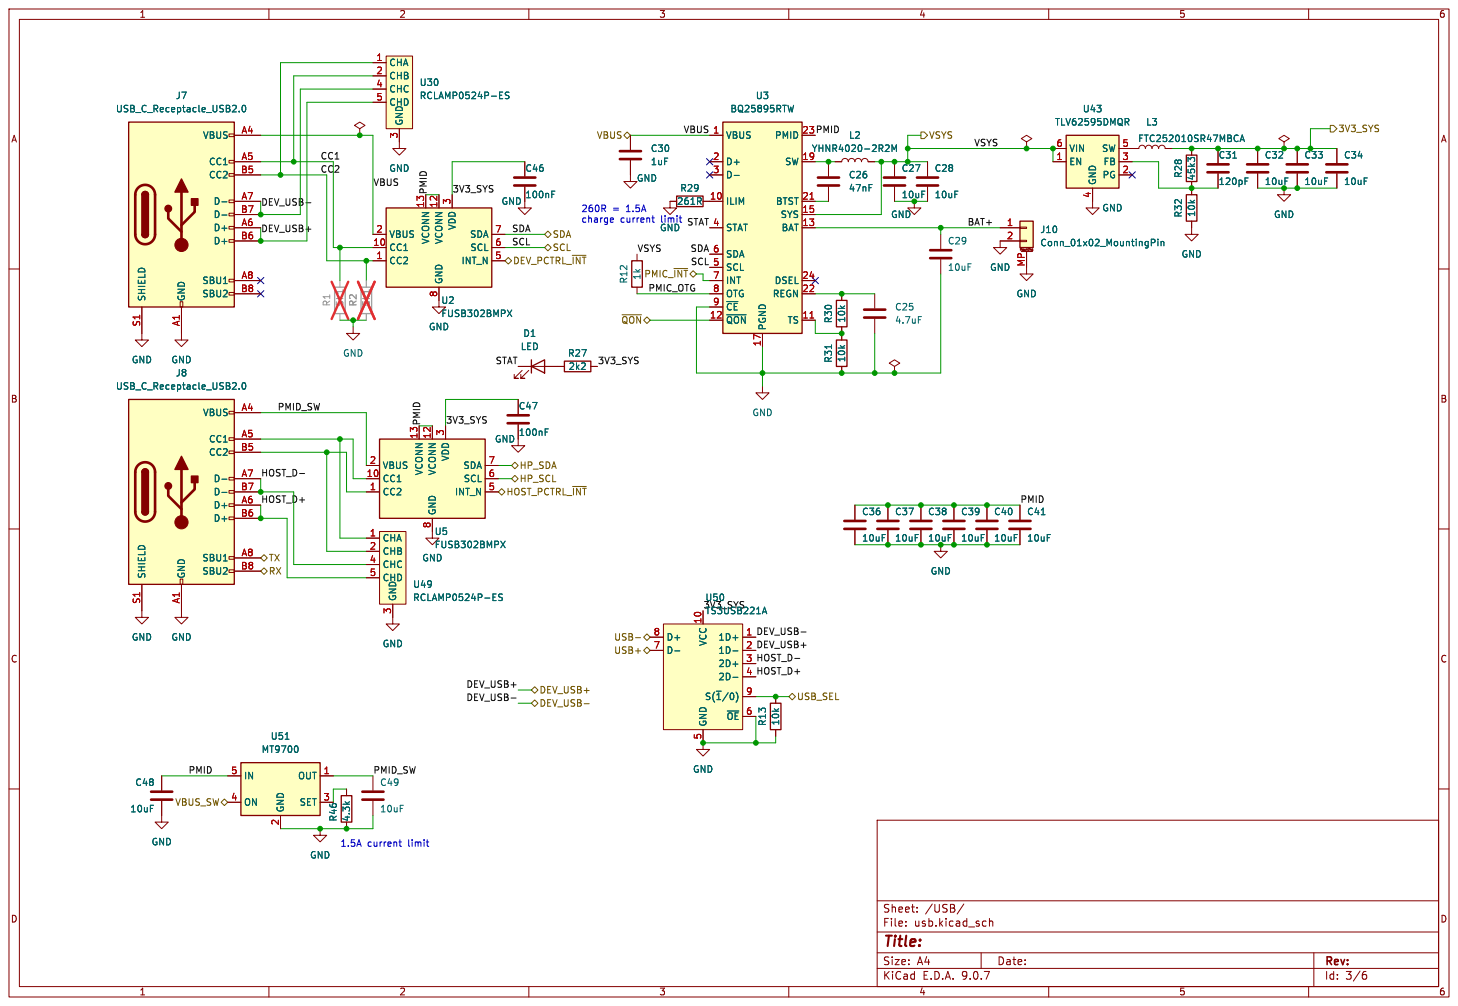
[picture p24: page 3]

8 VCONN 13 VBUS 2 CC1 10 CC2 1 U2 FUSB302BMPX GND GND

8 VCONN 13 VBUS 2 CC1 10 CC2 1 U5 FUSB302BMPX CHA 1 CHB 2 CHC 4 CHD 5 GND

8 VCONN 13 VBUS 2 CC1 10 CC2 1 GND GND GND

2 OUT 1 SET 3 GND R46 4.3k GND

Id: 3/6 Title: File: usb.kicad_sch Sheet: /USB/

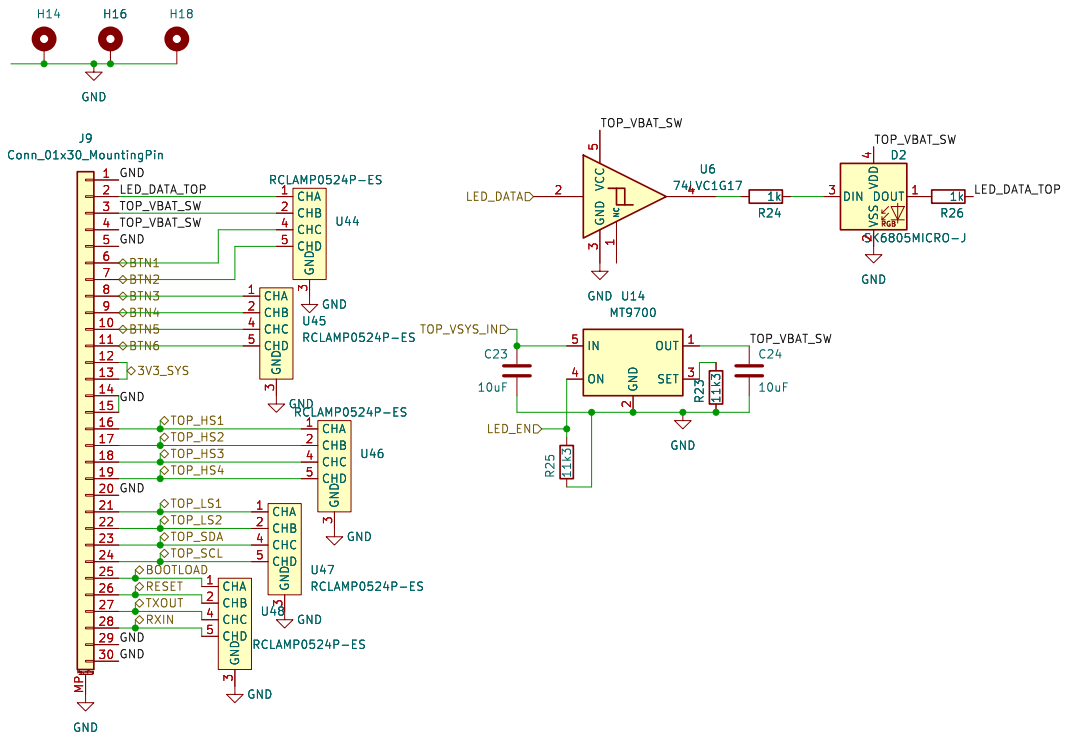
[picture p25: page 4]

2 OUT 1 SET 3 U14 MT9700 GND GND

3 U45 RCLAMP0524P-ES CHA 1 CHB 2 CHC 4 CHD 5 GND

3 U46 RCLAMP0524P-ES CHA 1 CHB 2 CHC 4 CHD 5 GND

3 U48 RCLAMP0524P-ES CHA 1 CHB 2 CHC 4 CHD 5 GND

3 U47 RCLAMP0524P-ES CHA 1 CHB 2 CHC 4 CHD 5 GND

Id: 4/6 Title: File: bot-top-link.kicad_sch Sheet: /bot-top-link/

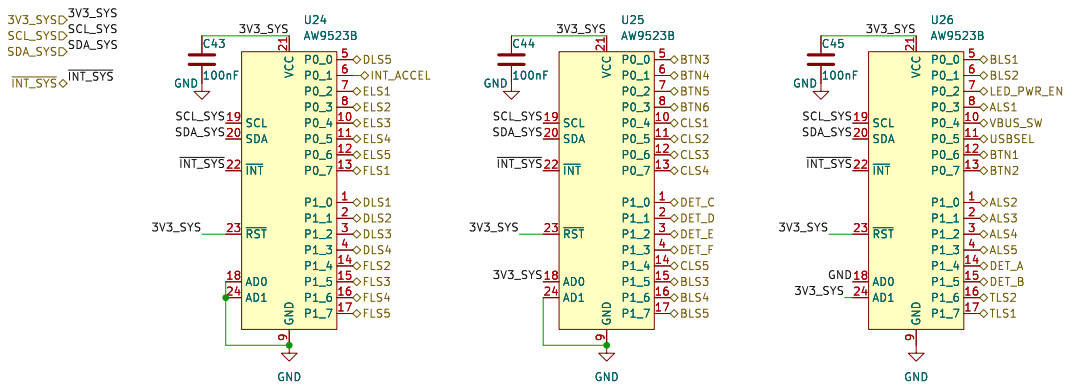
[picture p26: page 5]

Id: 5/6 Title: File: gpio-mux.kicad_sch Sheet: /GPIO/

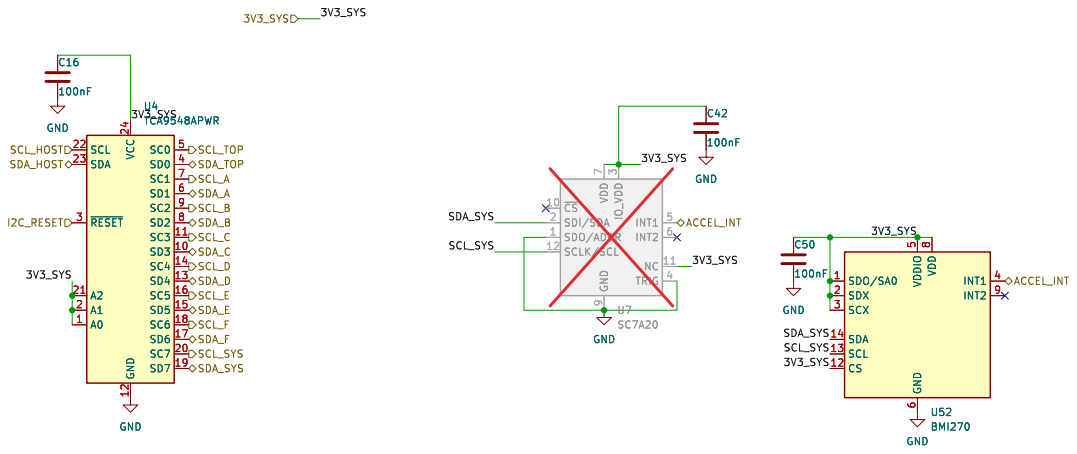
[picture p27: page 6]

Id: 6/6 Title: File: base-i2c.kicad_sch Sheet: /I2C/
