emfcamp/badge-2024-hardware/tildagon-base/tildagon-top.pdf

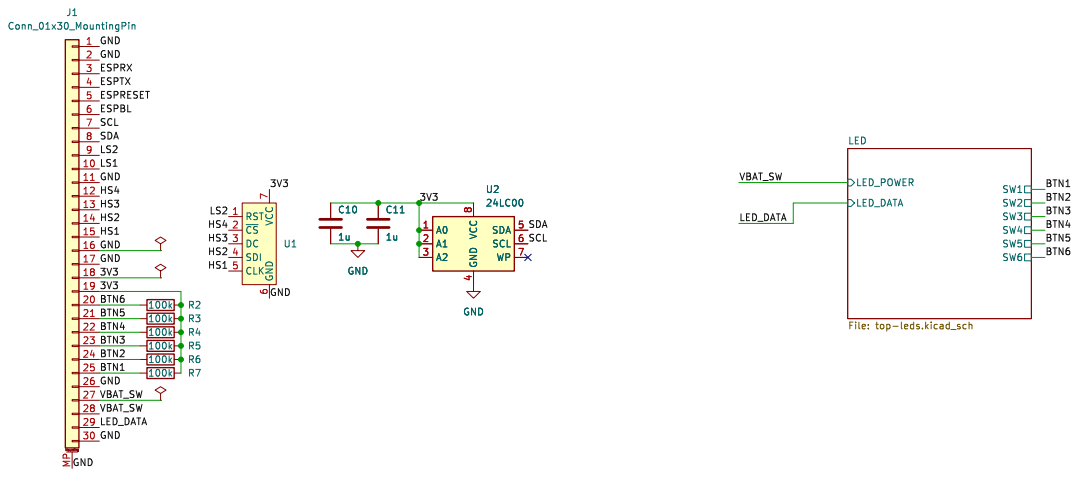
[picture p28: page 1]

4 SDA 5 SCL 6 WP 7 VCC

Id: 1/2 Title: File: tildagon-top.kicad_sch Sheet: /

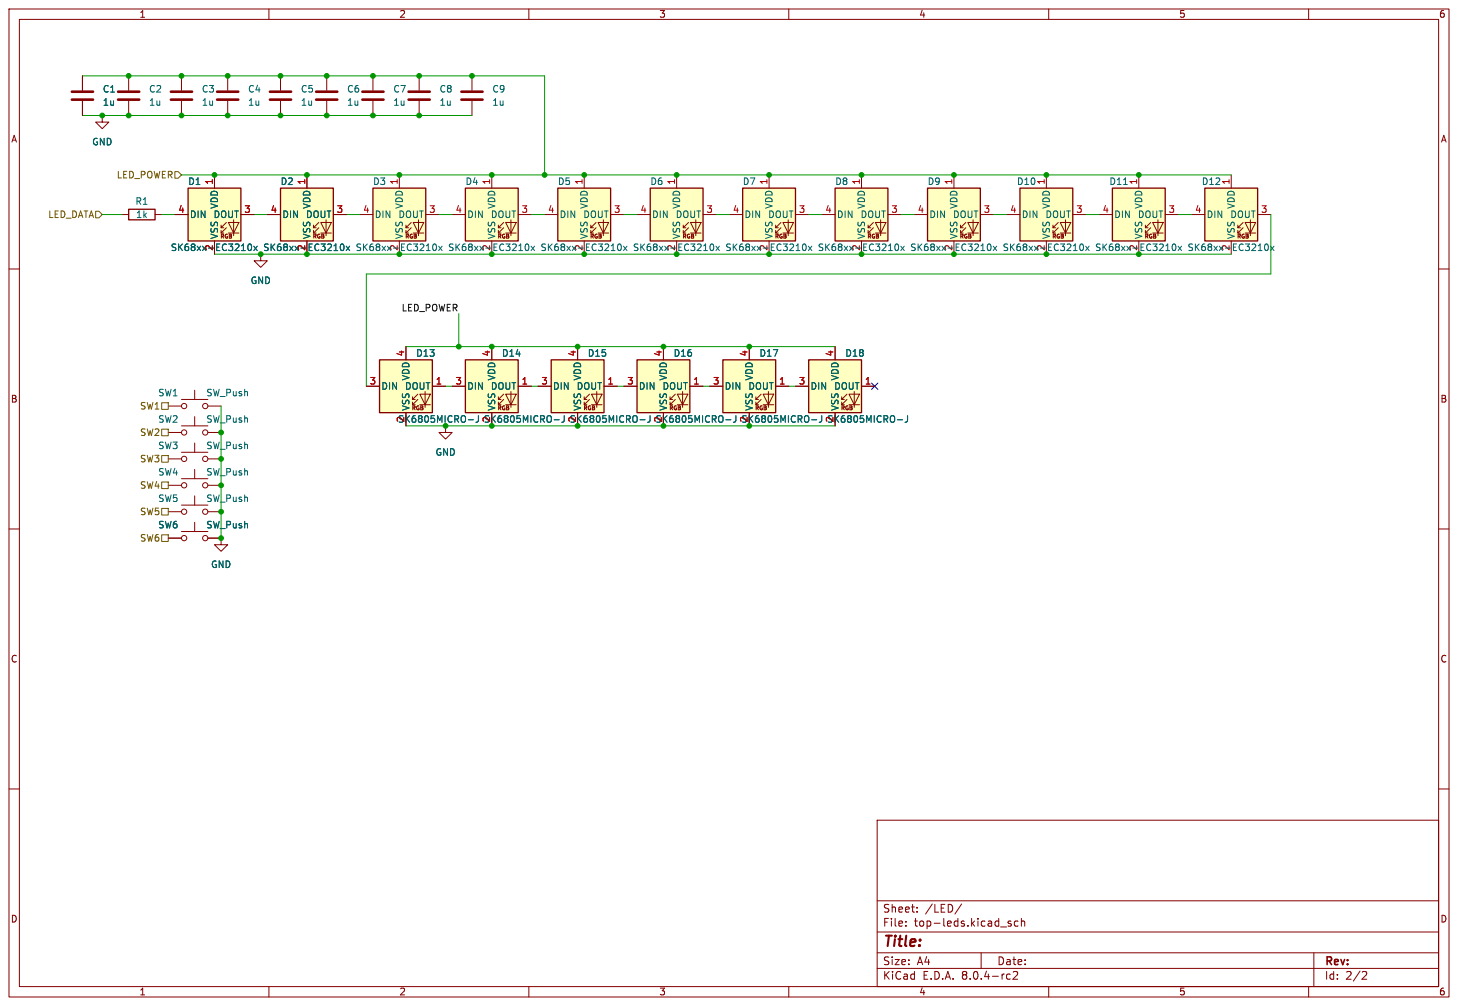
[picture p29: page 2]

Id: 2/2 Title: File: top-leds.kicad_sch Sheet: /LED/
