emfcamp/badge-2024-hardware/tildagon-2026/tildagon-2026-mid/tildagon-2026-mid.pdf

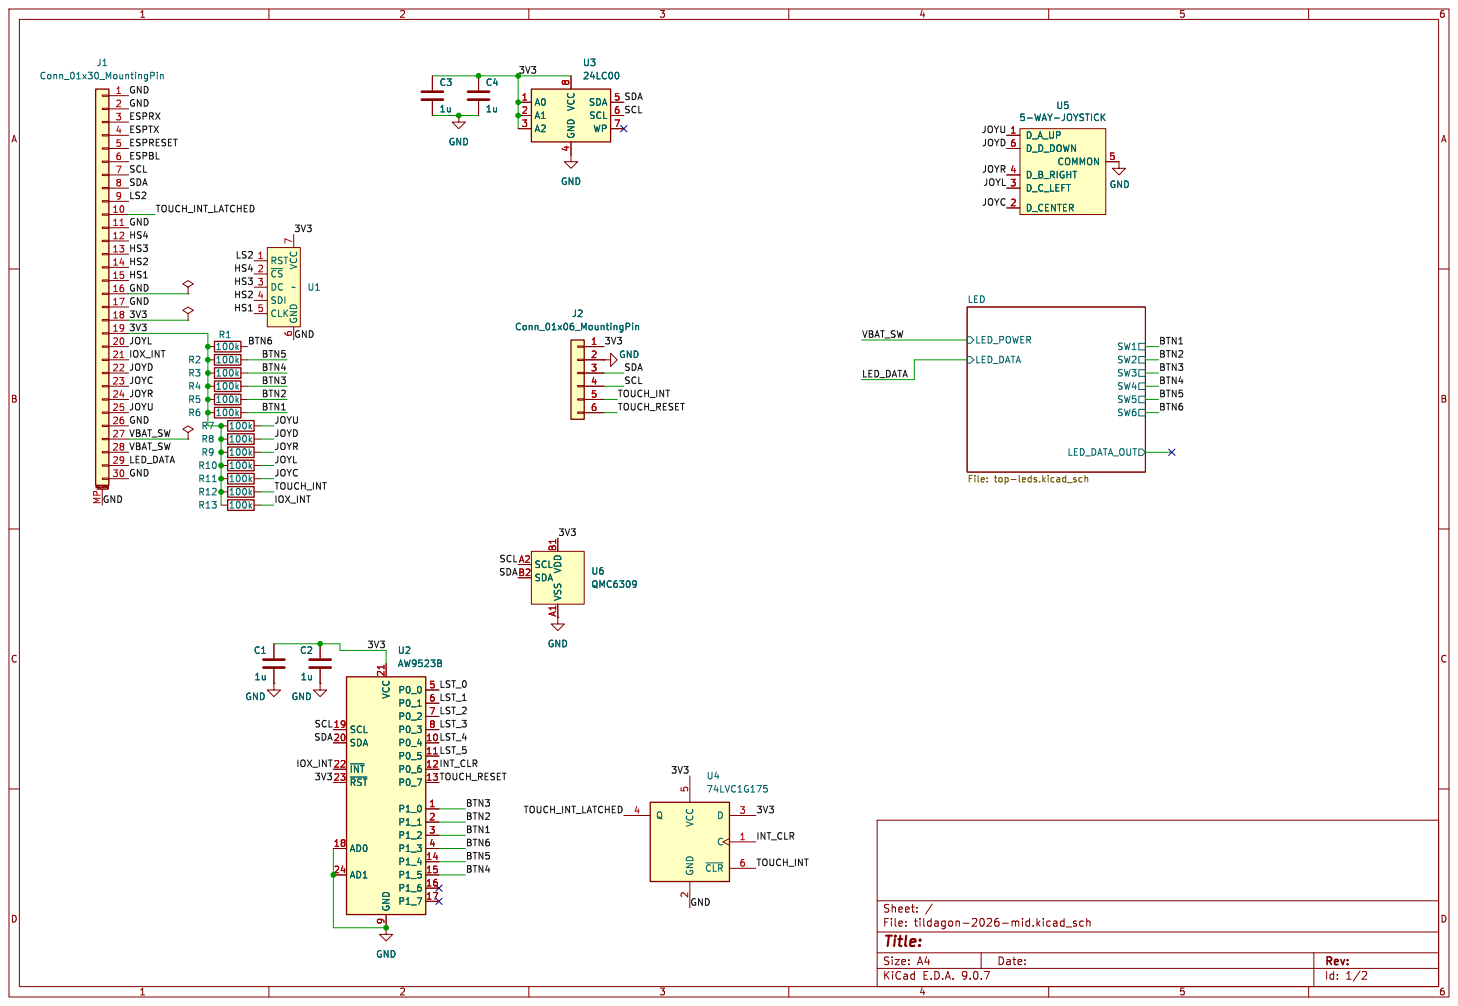
[picture p30: page 1]

Id: 1/2 Title: File: tildagon-2026-mid.kicad_sch Sheet: /

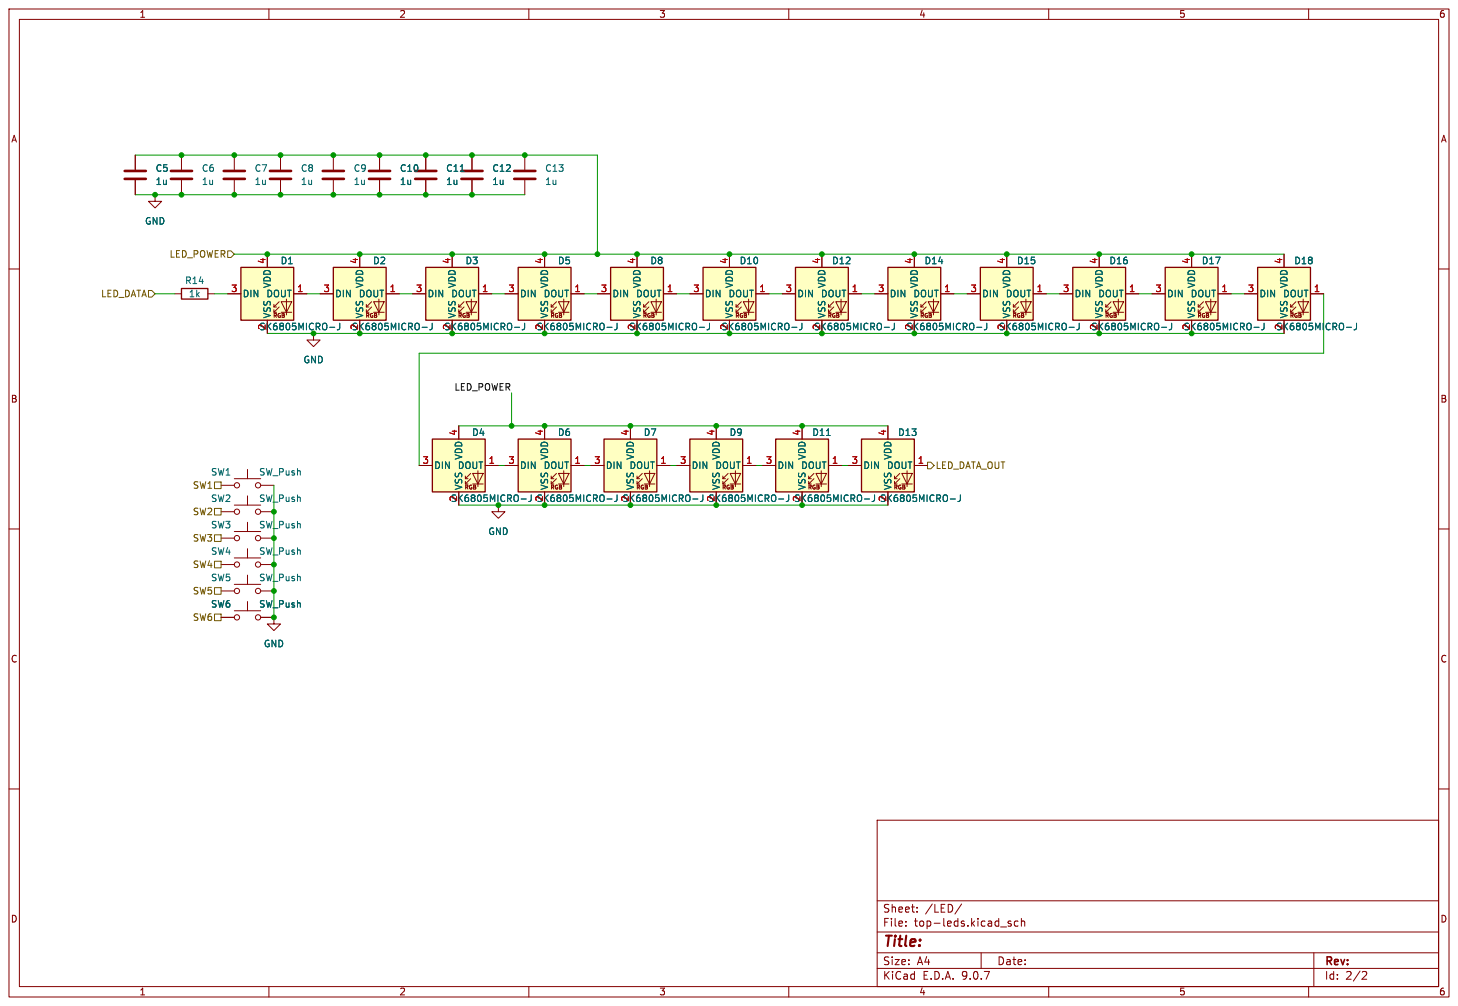
[picture p31: page 2]

Id: 2/2 Title: File: top-leds.kicad_sch Sheet: /LED/
