emfcamp/badge-2024-hardware/tildagon-2026/tildagon-2026-touch/tildagon-2026-touch.pdf

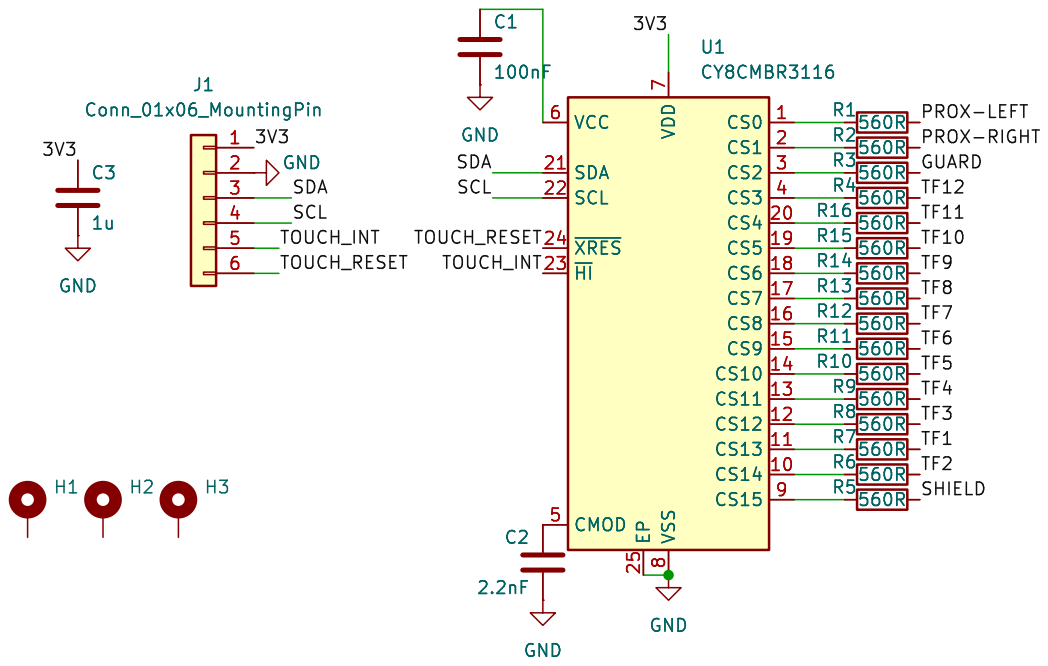
[picture p32: page 1]

8 EP 25 VCC 6 SDA 21 SCL 22 ~{XRES} 24 ~{HI} 23 CMOD 5 U1 CY8CMBR3116

8 EP 25 VCC 6 SDA 21 SCL 22 ~{XRES} 24 ~{HI} 23 CMOD 5 GND

TF11 TF12 PROX-LEFT PROX-RIGHT

Id: 1/1 Title: File: tildagon-2026-touch.kicad_sch Sheet: /
