emfcamp/badge-2024-hardware/tildagon-base/tildagon-base.kicad_pcb

## KiCad design tildagon-base/tildagon-base.kicad_pcb (2026-07-23)

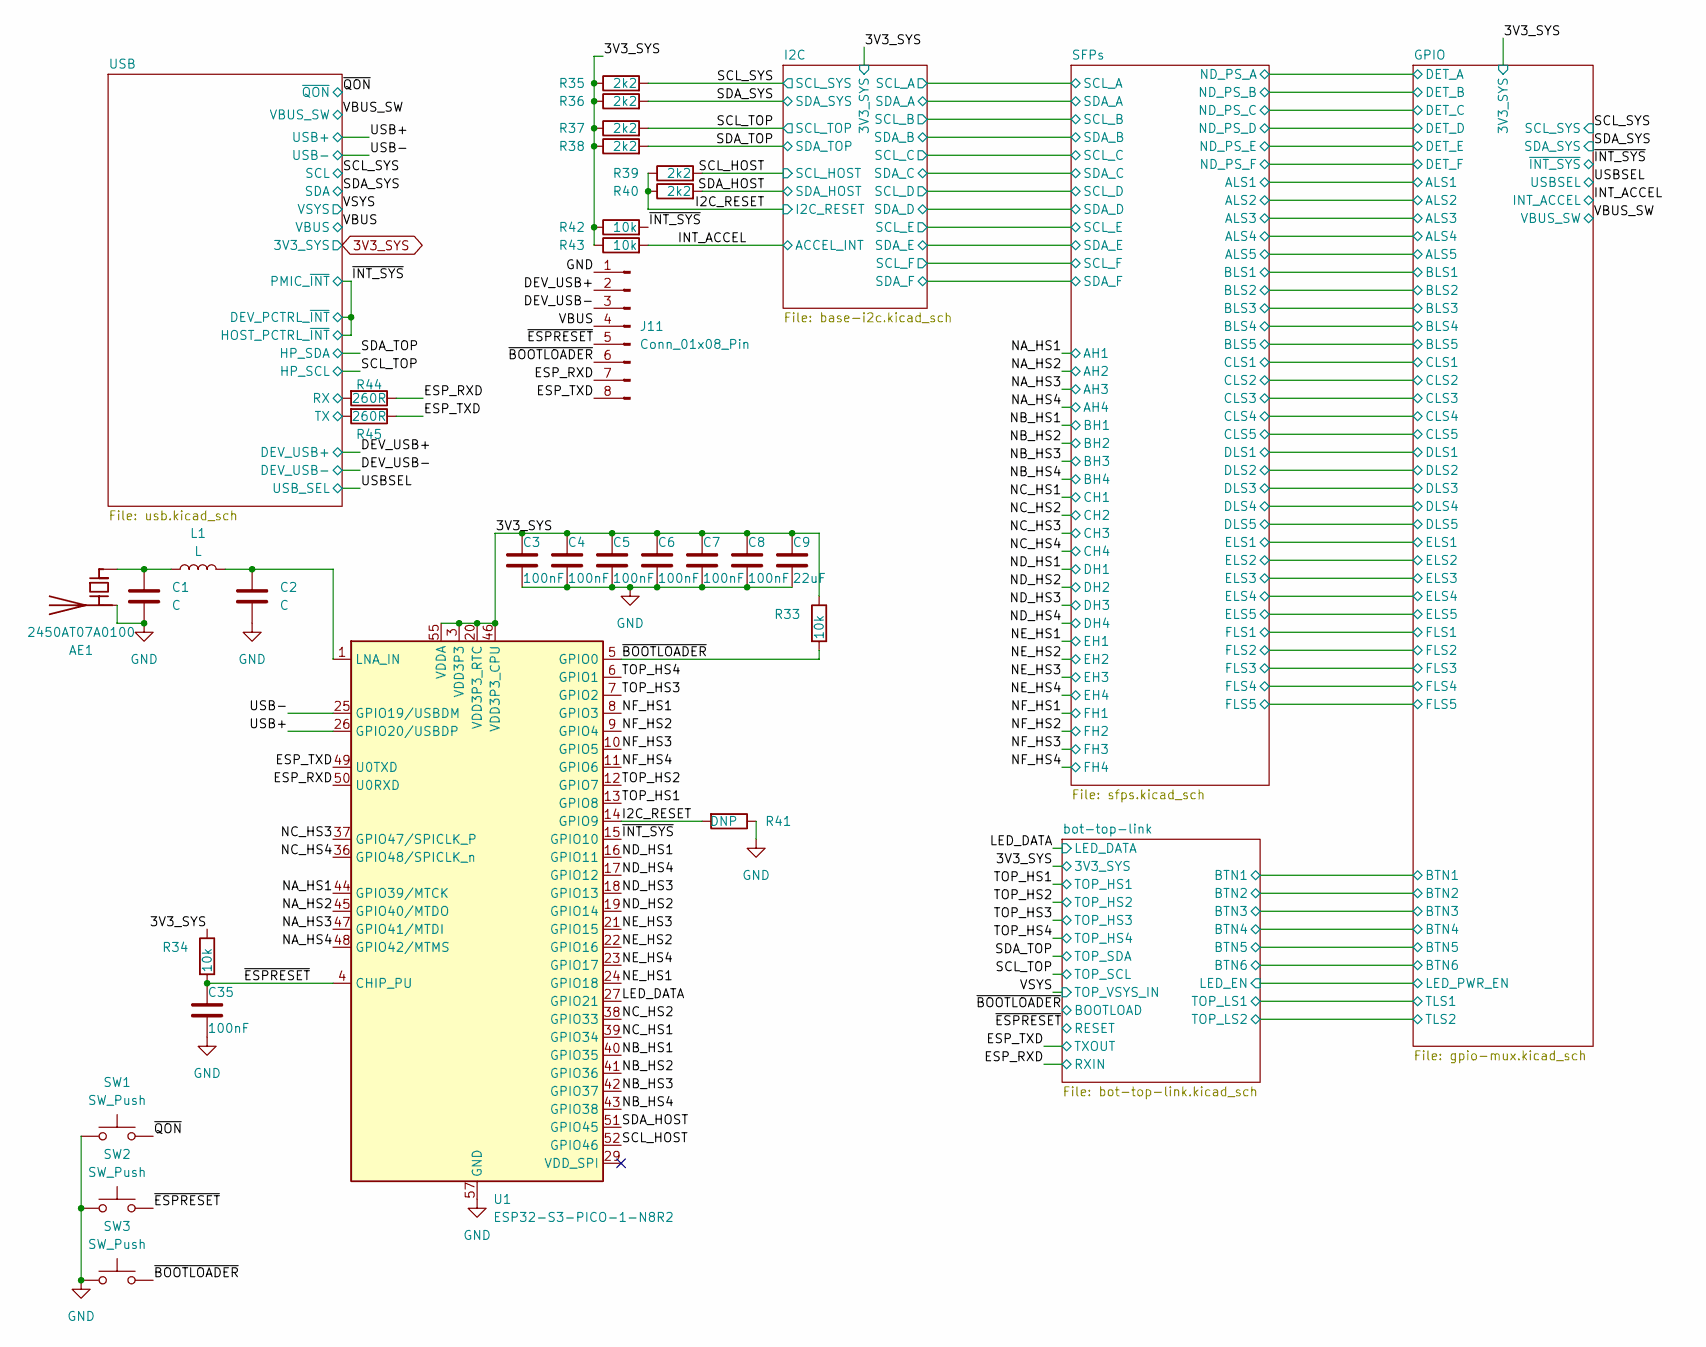
[picture p37: schematic tildagon-base.kicad_sch]

Parts:
AE1: 2450AT07A0100; Johanson_2450AT07A0100_FLRight
C1, C2: C; C_0402_1005Metric
C3, C4, C5, C6, C7, C8, C35: 100nF; C_0402_1005Metric
C9: 22uF; C_1206_3216Metric
J11: Conn_01x08_Pin; SOIC_clipProgSmall
L1: L; L_0402_1005Metric
R33, R34, R42, R43: 10k; R_0402_1005Metric
R35, R36, R37, R38, R39, R40: 2k2; R_0402_1005Metric
R41: DNP; R_0402_1005Metric
R44, R45: 260R; R_0402_1005Metric
SW1, SW2, SW3: SW_Push; sidebutton-1TS003B-1400-3500A-CT
U1: ESP32-S3-PICO-1-N8R2; LGA56-1EP_7x7mm_P0.4mm_EP4x4mm

Connections:
3V3_SYS: C3.1, C4.1, C5.1, C6.1, C7.1, C8.1, C9.1, R33.1, R34.1, R35.1, R36.1, R37.1, R38.1, R42.1, R43.1, U1.2 (VDD3P3), U1.3 (VDD3P3), U1.20 (VDD3P3_RTC), U1.46 (VDD3P3_CPU), U1.55 (VDDA), U1.56 (VDDA); also elsewhere on the board
/DEV_USB+: J11.2; also elsewhere on the board
/DEV_USB-: J11.3; also elsewhere on the board
/ESP_RXD: J11.7, R44.1, U1.50 (U0RXD); also elsewhere on the board
/ESP_TXD: J11.8, R45.1, U1.49 (U0TXD); also elsewhere on the board
/I2C_RESET: R39.1, R40.1, R41.2, U1.14 (GPIO9); also elsewhere on the board
/INT_ACCEL: R43.2; also elsewhere on the board
/LED_DATA: U1.27 (GPIO21); also elsewhere on the board
/NA_HS1: U1.44 (GPIO39/MTCK); also elsewhere on the board
/NA_HS2: U1.45 (GPIO40/MTDO); also elsewhere on the board
/NA_HS3: U1.47 (GPIO41/MTDI); also elsewhere on the board
/NA_HS4: U1.48 (GPIO42/MTMS); also elsewhere on the board
/NB_HS1: U1.40 (GPIO35); also elsewhere on the board
/NB_HS2: U1.41 (GPIO36); also elsewhere on the board
/NB_HS3: U1.42 (GPIO37); also elsewhere on the board
/NB_HS4: U1.43 (GPIO38); also elsewhere on the board
/NC_HS1: U1.39 (GPIO34); also elsewhere on the board
/NC_HS2: U1.38 (GPIO33); also elsewhere on the board
/NC_HS3: U1.37 (GPIO47/SPICLK_P); also elsewhere on the board
/NC_HS4: U1.36 (GPIO48/SPICLK_n); also elsewhere on the board
/ND_HS1: U1.16 (GPIO11); also elsewhere on the board
/ND_HS2: U1.19 (GPIO14); also elsewhere on the board
/ND_HS3: U1.18 (GPIO13); also elsewhere on the board
/ND_HS4: U1.17 (GPIO12); also elsewhere on the board
/NE_HS1: U1.24 (GPIO18); also elsewhere on the board
/NE_HS2: U1.22 (GPIO16); also elsewhere on the board
/NE_HS3: U1.21 (GPIO15); also elsewhere on the board
/NE_HS4: U1.23 (GPIO17); also elsewhere on the board
/NF_HS1: U1.8 (GPIO3); also elsewhere on the board
/NF_HS2: U1.9 (GPIO4); also elsewhere on the board
/NF_HS3: U1.10 (GPIO5); also elsewhere on the board
/NF_HS4: U1.11 (GPIO6); also elsewhere on the board
/SCL_HOST: R39.2, U1.52 (GPIO46); also elsewhere on the board
/SCL_SYS: R35.2; also elsewhere on the board
/SCL_TOP: R37.2; also elsewhere on the board
/SDA_HOST: R40.2, U1.51 (GPIO45); also elsewhere on the board
/SDA_SYS: R36.2; also elsewhere on the board
/SDA_TOP: R38.2; also elsewhere on the board
/TOP_HS1: U1.13 (GPIO8); also elsewhere on the board
/TOP_HS2: U1.12 (GPIO7); also elsewhere on the board
/TOP_HS3: U1.7 (GPIO2); also elsewhere on the board
/TOP_HS4: U1.6 (GPIO1); also elsewhere on the board
/USB+: U1.26 (GPIO20/USBDP); also elsewhere on the board
/USB-: U1.25 (GPIO19/USBDM); also elsewhere on the board
/USB/RX: R44.2; also elsewhere on the board
/USB/TX: R45.2; also elsewhere on the board
/VBUS: J11.4; also elsewhere on the board
/~BOOTLOADER: J11.6, R33.2, SW3.2, U1.5 (GPIO0); also elsewhere on the board
/~ESPRESET: C35.1, J11.5, R34.2, SW2.2, U1.4 (CHIP_PU); also elsewhere on the board
/~INT_SYS: R42.2, U1.15 (GPIO10); also elsewhere on the board
/~QON: SW1.2; also elsewhere on the board
GND: AE1.2 (PCB_Trace), C1.2, C2.2, C3.2, C4.2, C5.2, C6.2, C7.2, C8.2, C9.2, C35.2, J11.1, R41.1, SW1.1, SW2.1, SW3.1, U1.57 (GND); also elsewhere on the board
unnamed: AE1.1 (FEED), C1.1, L1.1
unnamed: C2.1, L1.2, U1.1 (LNA_IN)

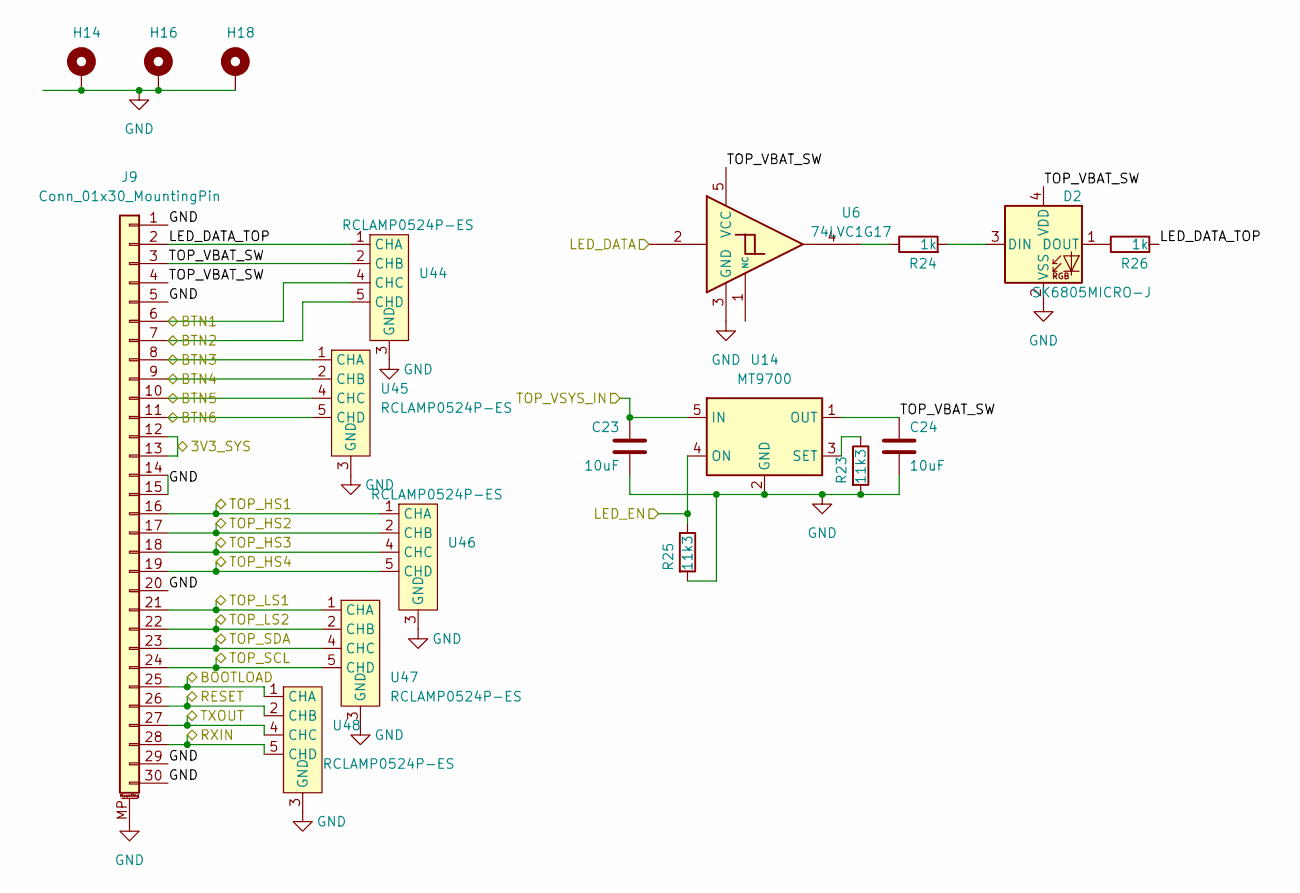
[picture p38: schematic bot-top-link.kicad_sch]

Parts:
C23, C24: 10uF; C_1206_3216Metric
D2: SK6805MICRO-J; LED_SK6805_PLCC4_2.4x2.7mm_P1.3mm
H14, H16, H18: MountingHole_Pad; SMTSO3030CTJ
J9: Conn_01x30_MountingPin; Jushuo_AFC01-S30FCC-00_1x30-1MP_P0.50mm_Horizontal
R23, R25: 11k3; R_0402_1005Metric
R24, R26: 1k; R_0402_1005Metric
U6: 74LVC1G17; SOT-353_SC-70-5
U14: MT9700; SOT-23-5
U44, U45, U46, U47, U48: RCLAMP0524P-ES; Diodes_UDFN-10_1.0x2.5mm_P0.5mm

Connections:
3V3_SYS: J9.12, J9.13; also elsewhere on the board
/ESP_RXD: J9.28, U48.5 (CHD), U48.6 (CHD); also elsewhere on the board
/ESP_TXD: J9.27, U48.4 (CHC), U48.7 (CHC); also elsewhere on the board
/GPIO/BTN1: J9.6, U44.4 (CHC), U44.7 (CHC); also elsewhere on the board
/GPIO/BTN2: J9.7, U44.5 (CHD), U44.6 (CHD); also elsewhere on the board
/GPIO/BTN3: J9.8, U45.1 (CHA), U45.10 (CHA); also elsewhere on the board
/GPIO/BTN4: J9.9, U45.2 (CHB), U45.9 (CHB); also elsewhere on the board
/GPIO/BTN5: J9.10, U45.4 (CHC), U45.7 (CHC); also elsewhere on the board
/GPIO/BTN6: J9.11, U45.5 (CHD), U45.6 (CHD); also elsewhere on the board
/GPIO/LED_PWR_EN: R25.1, U14.4 (ON); also elsewhere on the board
/GPIO/TLS1: J9.21, U47.1 (CHA), U47.10 (CHA); also elsewhere on the board
/GPIO/TLS2: J9.22, U47.2 (CHB), U47.9 (CHB); also elsewhere on the board
/LED_DATA: U6.2; also elsewhere on the board
/SCL_TOP: J9.24, U47.5 (CHD), U47.6 (CHD); also elsewhere on the board
/SDA_TOP: J9.23, U47.4 (CHC), U47.7 (CHC); also elsewhere on the board
/TOP_HS1: J9.16, U46.1 (CHA), U46.10 (CHA); also elsewhere on the board
/TOP_HS2: J9.17, U46.2 (CHB), U46.9 (CHB); also elsewhere on the board
/TOP_HS3: J9.18, U46.4 (CHC), U46.7 (CHC); also elsewhere on the board
/TOP_HS4: J9.19, U46.5 (CHD), U46.6 (CHD); also elsewhere on the board
/VSYS: C23.1, U14.5 (IN); also elsewhere on the board
/bot-top-link/LED_DATA_TOP: J9.2, R26.2, U44.1 (CHA), U44.10 (CHA)
/bot-top-link/TOP_VBAT_SW: C24.1, D2.4 (VDD), J9.3, J9.4, U6.5 (VCC), U14.1 (OUT), U44.2 (CHB), U44.9 (CHB)
/~BOOTLOADER: J9.25, U48.1 (CHA), U48.10 (CHA); also elsewhere on the board
/~ESPRESET: J9.26, U48.2 (CHB), U48.9 (CHB); also elsewhere on the board
GND: C23.2, C24.2, D2.2 (VSS), H14.1, H16.1, H18.1, J9.1, J9.5, J9.14, J9.15, J9.20, J9.29, J9.30, J9.MP (MountPin), R23.2, R25.2, U6.3 (GND), U14.2 (GND), U44.3 (GND), U44.8 (GND), U45.3 (GND), U45.8 (GND), U46.3 (GND), U46.8 (GND), U47.3 (GND), U47.8 (GND), U48.3 (GND), U48.8 (GND); also elsewhere on the board
unnamed: D2.3 (DIN), R24.2
unnamed: D2.1 (DOUT), R26.1
unnamed: R24.1, U6.4
unnamed: R23.1, U14.3 (SET)

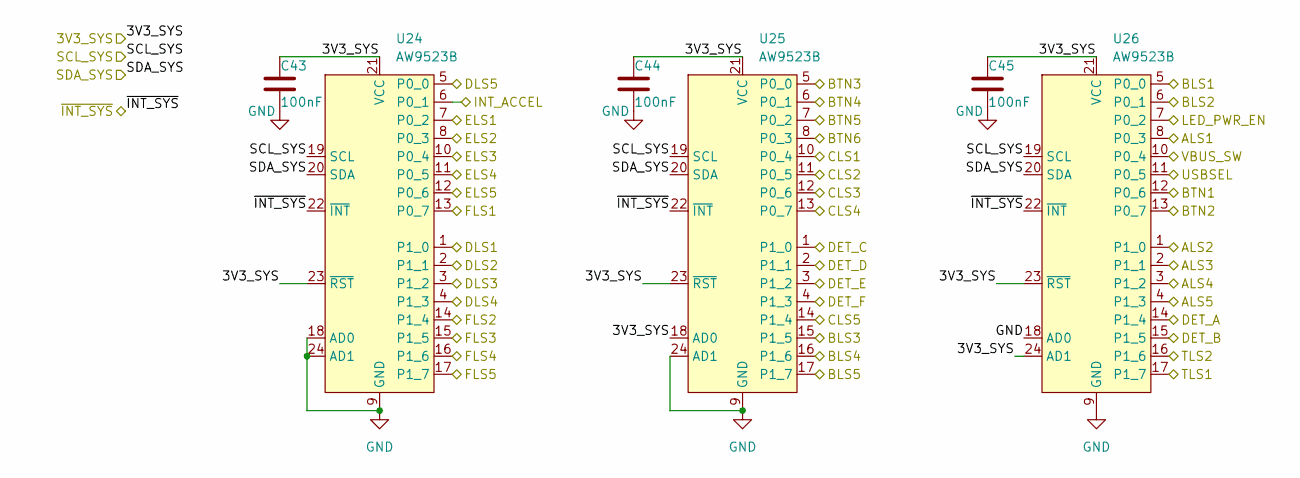
[picture p39: schematic gpio-mux.kicad_sch]

Parts:
C43, C44, C45: 100nF; C_0402_1005Metric
U24, U25, U26: AW9523B; QFN-24-1EP_4x4mm_P0.5mm_EP2.7x2.6mm

Connections:
3V3_SYS: C43.1, C44.1, C45.1, U24.21 (VCC), U24.23 (~RST), U25.18 (AD0), U25.21 (VCC), U25.23 (~RST), U26.21 (VCC), U26.23 (~RST), U26.24 (AD1); also elsewhere on the board
/GPIO/ALS1: U26.8 (P0_3); also elsewhere on the board
/GPIO/ALS2: U26.1 (P1_0); also elsewhere on the board
/GPIO/ALS3: U26.2 (P1_1); also elsewhere on the board
/GPIO/ALS4: U26.3 (P1_2); also elsewhere on the board
/GPIO/ALS5: U26.4 (P1_3); also elsewhere on the board
/GPIO/BLS1: U26.5 (P0_0); also elsewhere on the board
/GPIO/BLS2: U26.6 (P0_1); also elsewhere on the board
/GPIO/BLS3: U25.15 (P1_5); also elsewhere on the board
/GPIO/BLS4: U25.16 (P1_6); also elsewhere on the board
/GPIO/BLS5: U25.17 (P1_7); also elsewhere on the board
/GPIO/BTN1: U26.12 (P0_6); also elsewhere on the board
/GPIO/BTN2: U26.13 (P0_7); also elsewhere on the board
/GPIO/BTN3: U25.5 (P0_0); also elsewhere on the board
/GPIO/BTN4: U25.6 (P0_1); also elsewhere on the board
/GPIO/BTN5: U25.7 (P0_2); also elsewhere on the board
/GPIO/BTN6: U25.8 (P0_3); also elsewhere on the board
/GPIO/CLS1: U25.10 (P0_4); also elsewhere on the board
/GPIO/CLS2: U25.11 (P0_5); also elsewhere on the board
/GPIO/CLS3: U25.12 (P0_6); also elsewhere on the board
/GPIO/CLS4: U25.13 (P0_7); also elsewhere on the board
/GPIO/CLS5: U25.14 (P1_4); also elsewhere on the board
/GPIO/DET_A: U26.14 (P1_4); also elsewhere on the board
/GPIO/DET_B: U26.15 (P1_5); also elsewhere on the board
/GPIO/DET_C: U25.1 (P1_0); also elsewhere on the board
/GPIO/DET_D: U25.2 (P1_1); also elsewhere on the board
/GPIO/DET_E: U25.3 (P1_2); also elsewhere on the board
/GPIO/DET_F: U25.4 (P1_3); also elsewhere on the board
/GPIO/DLS1: U24.1 (P1_0); also elsewhere on the board
/GPIO/DLS2: U24.2 (P1_1); also elsewhere on the board
/GPIO/DLS3: U24.3 (P1_2); also elsewhere on the board
/GPIO/DLS4: U24.4 (P1_3); also elsewhere on the board
/GPIO/DLS5: U24.5 (P0_0); also elsewhere on the board
/GPIO/ELS1: U24.7 (P0_2); also elsewhere on the board
/GPIO/ELS2: U24.8 (P0_3); also elsewhere on the board
/GPIO/ELS3: U24.10 (P0_4); also elsewhere on the board
/GPIO/ELS4: U24.11 (P0_5); also elsewhere on the board
/GPIO/ELS5: U24.12 (P0_6); also elsewhere on the board
/GPIO/FLS1: U24.13 (P0_7); also elsewhere on the board
/GPIO/FLS2: U24.14 (P1_4); also elsewhere on the board
/GPIO/FLS3: U24.15 (P1_5); also elsewhere on the board
/GPIO/FLS4: U24.16 (P1_6); also elsewhere on the board
/GPIO/FLS5: U24.17 (P1_7); also elsewhere on the board
/GPIO/LED_PWR_EN: U26.7 (P0_2); also elsewhere on the board
/GPIO/TLS1: U26.17 (P1_7); also elsewhere on the board
/GPIO/TLS2: U26.16 (P1_6); also elsewhere on the board
/INT_ACCEL: U24.6 (P0_1); also elsewhere on the board
/SCL_SYS: U24.19 (SCL), U25.19 (SCL), U26.19 (SCL); also elsewhere on the board
/SDA_SYS: U24.20 (SDA), U25.20 (SDA), U26.20 (SDA); also elsewhere on the board
/USBSEL: U26.11 (P0_5); also elsewhere on the board
/VBUS_SW: U26.10 (P0_4); also elsewhere on the board
/~INT_SYS: U24.22 (~INT), U25.22 (~INT), U26.22 (~INT); also elsewhere on the board
GND: C43.2, C44.2, C45.2, U24.9 (GND), U24.18 (AD0), U24.24 (AD1), U24.25 (GND), U25.9 (GND), U25.24 (AD1), U25.25 (GND), U26.9 (GND), U26.18 (AD0), U26.25 (GND); also elsewhere on the board

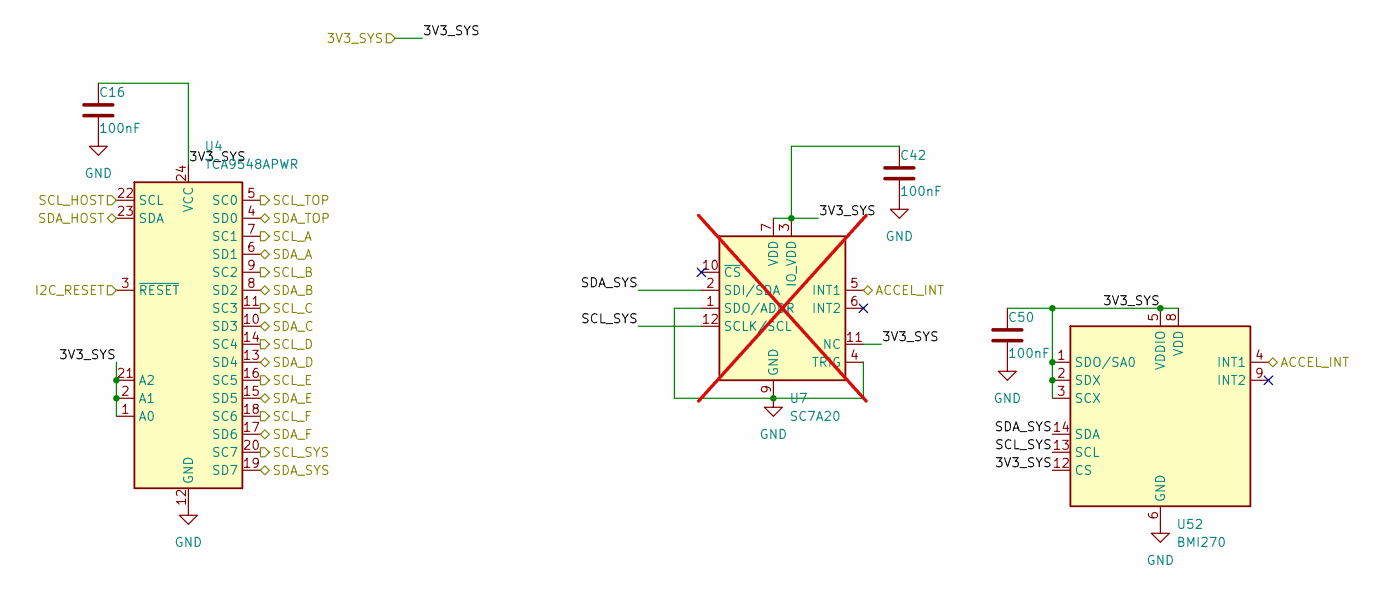
[picture p40: schematic base-i2c.kicad_sch]

Parts:
C16, C42, C50: 100nF; C_0402_1005Metric
U4: TCA9548APWR; TSSOP-24_4.4x7.8mm_P0.65mm
U7: SC7A20; LGA-12_2x2mm_P0.5mm; not fitted
U52: BMI270; LGA-14_3x2.5mm_P0.5mm_LayoutBorder3x4y

Connections:
3V3_SYS: C16.1, C42.1, C50.1, U4.1 (A0), U4.2 (A1), U4.21 (A2), U4.24 (VCC), U7.3 (IO_VDD), U7.7 (VDD), U7.11 (NC), U52.1 (SDO/SA0), U52.2 (SDX), U52.3 (SCX), U52.5 (VDDIO), U52.8 (VDD), U52.12 (CS); also elsewhere on the board
/I2C/SCL_A: U4.7 (SC1); also elsewhere on the board
/I2C/SCL_B: U4.9 (SC2); also elsewhere on the board
/I2C/SCL_C: U4.11 (SC3); also elsewhere on the board
/I2C/SCL_D: U4.14 (SC4); also elsewhere on the board
/I2C/SCL_E: U4.16 (SC5); also elsewhere on the board
/I2C/SCL_F: U4.18 (SC6); also elsewhere on the board
/I2C/SDA_A: U4.6 (SD1); also elsewhere on the board
/I2C/SDA_B: U4.8 (SD2); also elsewhere on the board
/I2C/SDA_C: U4.10 (SD3); also elsewhere on the board
/I2C/SDA_D: U4.13 (SD4); also elsewhere on the board
/I2C/SDA_E: U4.15 (SD5); also elsewhere on the board
/I2C/SDA_F: U4.17 (SD6); also elsewhere on the board
/I2C_RESET: U4.3 (~RESET); also elsewhere on the board
/INT_ACCEL: U7.5 (INT1), U52.4 (INT1); also elsewhere on the board
/SCL_HOST: U4.22 (SCL); also elsewhere on the board
/SCL_SYS: U4.20 (SC7), U7.12 (SCLK/SCL), U52.13 (SCL); also elsewhere on the board
/SCL_TOP: U4.5 (SC0); also elsewhere on the board
/SDA_HOST: U4.23 (SDA); also elsewhere on the board
/SDA_SYS: U4.19 (SD7), U7.2 (SDI/SDA), U52.14 (SDA); also elsewhere on the board
/SDA_TOP: U4.4 (SD0); also elsewhere on the board
GND: C16.2, C42.2, C50.2, U4.12 (GND), U7.1 (SDO/ADDR), U7.4 (TRIG), U7.9 (GND), U52.6 (GND), U52.7 (GND); also elsewhere on the board
