emfcamp/badge-2024-hardware/tildagon-base/tildagon-base.kicad_pcb

## KiCad design tildagon-base/tildagon-base.kicad_pcb (continued)

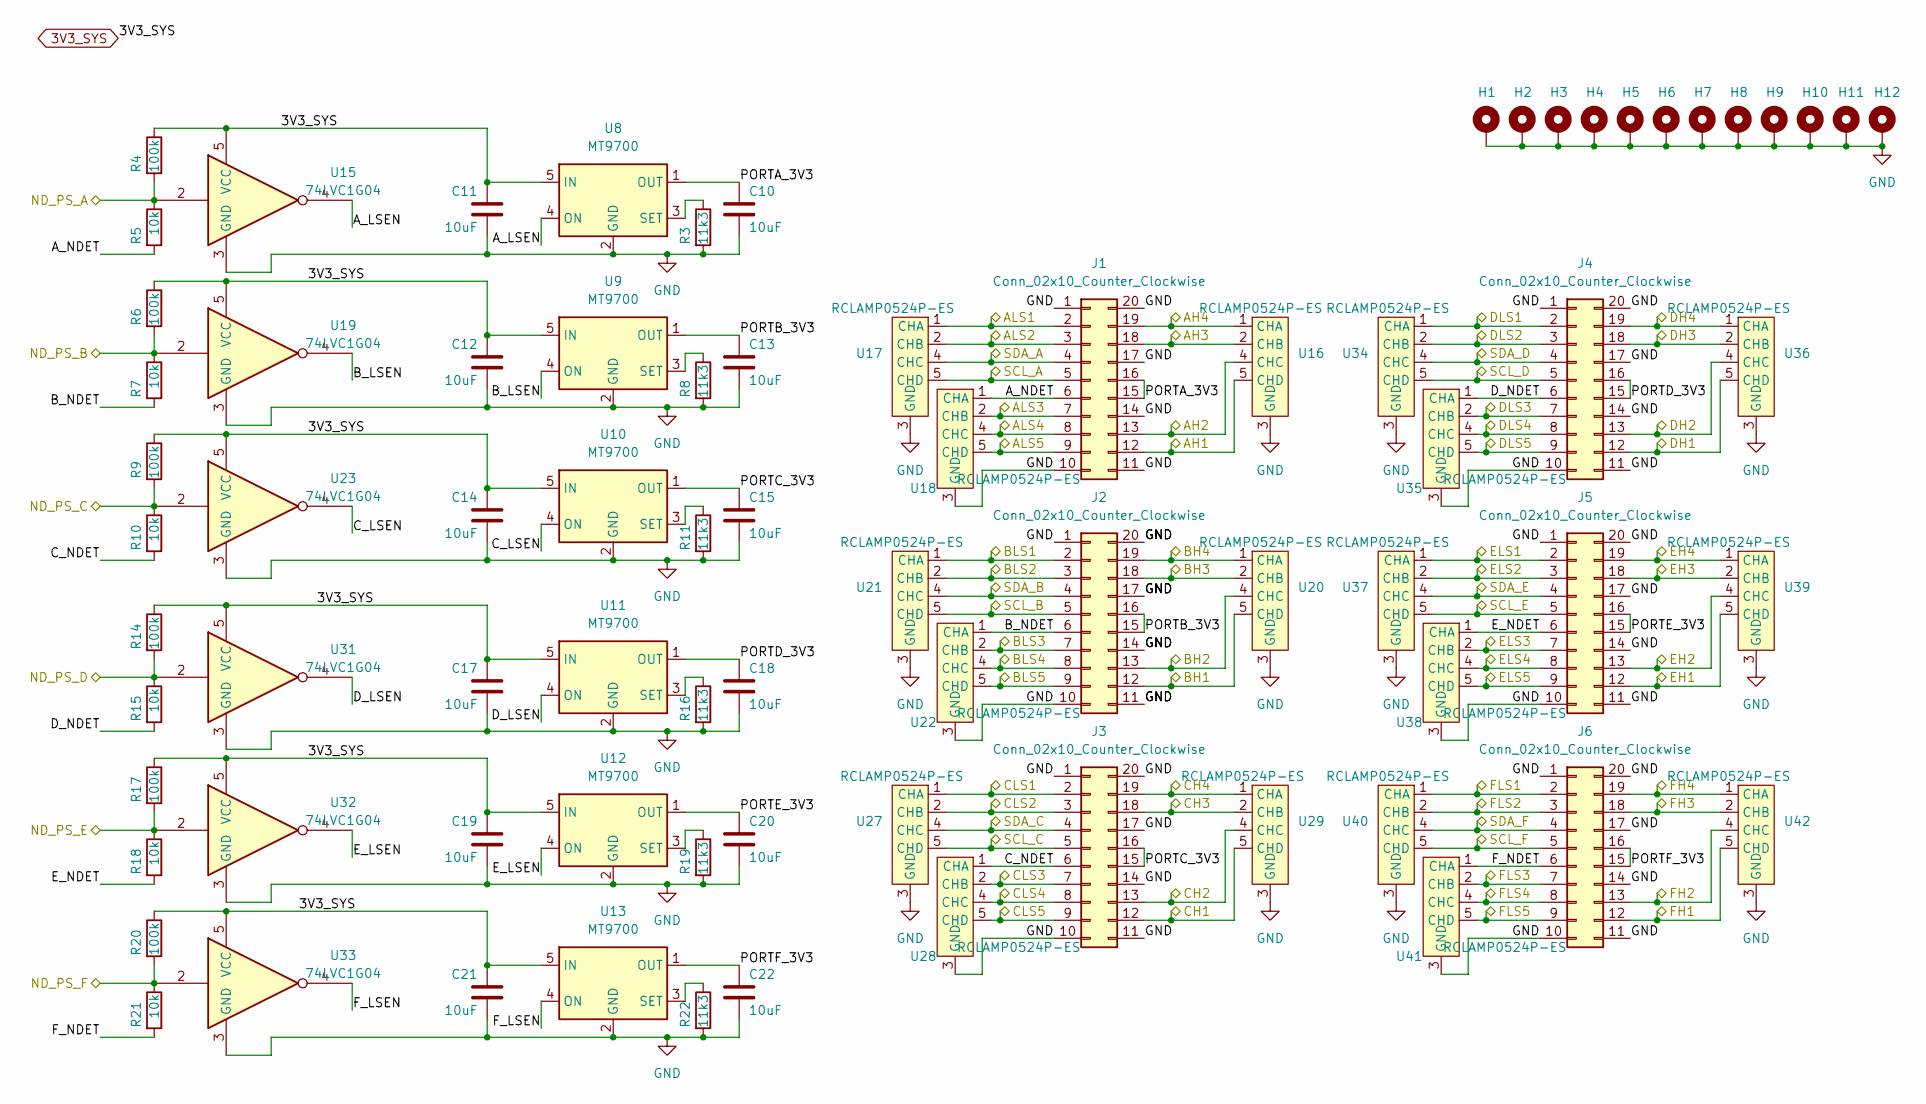
[picture p41: schematic sfps.kicad_sch]

Parts:
C10, C11, C12, C13, C14, C15, C17, C18, C19, C20, C21, C22: 10uF; C_1206_3216Metric
H1, H2, H3, H4, H5, H6, H7, H8, H9, H10, H11, H12: MountingHole_Pad; SMTSO2030CTJ
J1, J2, J3, J4, J5, J6: Conn_02x10_Counter_Clockwise; SFP
R3, R8, R11, R16, R19, R22: 11k3; R_0402_1005Metric
R4, R6, R9, R14, R17, R20: 100k; R_0402_1005Metric
R5, R7, R10, R15, R18, R21: 10k; R_0402_1005Metric
U8, U9, U10, U11, U12, U13: MT9700; SOT-23-5
U15, U19, U23, U31, U32, U33: 74LVC1G04; SOT-353_SC-70-5
U16, U17, U18, U20, U21, U22, U27, U28, U29, U34, U35, U36, U37, U38, U39, U40, U41, U42: RCLAMP0524P-ES; Diodes_UDFN-10_1.0x2.5mm_P0.5mm

Connections:
3V3_SYS: C11.1, C12.1, C14.1, C17.1, C19.1, C21.1, R4.1, R6.1, R9.1, R14.1, R17.1, R20.1, U8.5 (IN), U9.5 (IN), U10.5 (IN), U11.5 (IN), U12.5 (IN), U13.5 (IN), U15.5 (VCC), U19.5 (VCC), U23.5 (VCC), U31.5 (VCC), U32.5 (VCC), U33.5 (VCC); also elsewhere on the board
/GPIO/ALS1: J1.2, U17.1 (CHA), U17.10 (CHA); also elsewhere on the board
/GPIO/ALS2: J1.3, U17.2 (CHB), U17.9 (CHB); also elsewhere on the board
/GPIO/ALS3: J1.7, U18.2 (CHB), U18.9 (CHB); also elsewhere on the board
/GPIO/ALS4: J1.8, U18.4 (CHC), U18.7 (CHC); also elsewhere on the board
/GPIO/ALS5: J1.9, U18.5 (CHD), U18.6 (CHD); also elsewhere on the board
/GPIO/BLS1: J2.2, U21.1 (CHA), U21.10 (CHA); also elsewhere on the board
/GPIO/BLS2: J2.3, U21.2 (CHB), U21.9 (CHB); also elsewhere on the board
/GPIO/BLS3: J2.7, U22.2 (CHB), U22.9 (CHB); also elsewhere on the board
/GPIO/BLS4: J2.8, U22.4 (CHC), U22.7 (CHC); also elsewhere on the board
/GPIO/BLS5: J2.9, U22.5 (CHD), U22.6 (CHD); also elsewhere on the board
/GPIO/CLS1: J3.2, U27.1 (CHA), U27.10 (CHA); also elsewhere on the board
/GPIO/CLS2: J3.3, U27.2 (CHB), U27.9 (CHB); also elsewhere on the board
/GPIO/CLS3: J3.7, U28.2 (CHB), U28.9 (CHB); also elsewhere on the board
/GPIO/CLS4: J3.8, U28.4 (CHC), U28.7 (CHC); also elsewhere on the board
/GPIO/CLS5: J3.9, U28.5 (CHD), U28.6 (CHD); also elsewhere on the board
/GPIO/DET_A: R4.2, R5.1, U15.2; also elsewhere on the board
/GPIO/DET_B: R6.2, R7.1, U19.2; also elsewhere on the board
/GPIO/DET_C: R9.2, R10.1, U23.2; also elsewhere on the board
/GPIO/DET_D: R14.2, R15.1, U31.2; also elsewhere on the board
/GPIO/DET_E: R17.2, R18.1, U32.2; also elsewhere on the board
/GPIO/DET_F: R20.2, R21.1, U33.2; also elsewhere on the board
/GPIO/DLS1: J4.2, U34.1 (CHA), U34.10 (CHA); also elsewhere on the board
/GPIO/DLS2: J4.3, U34.2 (CHB), U34.9 (CHB); also elsewhere on the board
/GPIO/DLS3: J4.7, U35.2 (CHB), U35.9 (CHB); also elsewhere on the board
/GPIO/DLS4: J4.8, U35.4 (CHC), U35.7 (CHC); also elsewhere on the board
/GPIO/DLS5: J4.9, U35.5 (CHD), U35.6 (CHD); also elsewhere on the board
/GPIO/ELS1: J5.2, U37.1 (CHA), U37.10 (CHA); also elsewhere on the board
/GPIO/ELS2: J5.3, U37.2 (CHB), U37.9 (CHB); also elsewhere on the board
/GPIO/ELS3: J5.7, U38.2 (CHB), U38.9 (CHB); also elsewhere on the board
/GPIO/ELS4: J5.8, U38.4 (CHC), U38.7 (CHC); also elsewhere on the board
/GPIO/ELS5: J5.9, U38.5 (CHD), U38.6 (CHD); also elsewhere on the board
/GPIO/FLS1: J6.2, U40.1 (CHA), U40.10 (CHA); also elsewhere on the board
/GPIO/FLS2: J6.3, U40.2 (CHB), U40.9 (CHB); also elsewhere on the board
/GPIO/FLS3: J6.7, U41.2 (CHB), U41.9 (CHB); also elsewhere on the board
/GPIO/FLS4: J6.8, U41.4 (CHC), U41.7 (CHC); also elsewhere on the board
/GPIO/FLS5: J6.9, U41.5 (CHD), U41.6 (CHD); also elsewhere on the board
/I2C/SCL_A: J1.5, U17.5 (CHD), U17.6 (CHD); also elsewhere on the board
/I2C/SCL_B: J2.5, U21.5 (CHD), U21.6 (CHD); also elsewhere on the board
/I2C/SCL_C: J3.5, U27.5 (CHD), U27.6 (CHD); also elsewhere on the board
/I2C/SCL_D: J4.5, U34.5 (CHD), U34.6 (CHD); also elsewhere on the board
/I2C/SCL_E: J5.5, U37.5 (CHD), U37.6 (CHD); also elsewhere on the board
/I2C/SCL_F: J6.5, U40.5 (CHD), U40.6 (CHD); also elsewhere on the board
/I2C/SDA_A: J1.4, U17.4 (CHC), U17.7 (CHC); also elsewhere on the board
/I2C/SDA_B: J2.4, U21.4 (CHC), U21.7 (CHC); also elsewhere on the board
/I2C/SDA_C: J3.4, U27.4 (CHC), U27.7 (CHC); also elsewhere on the board
/I2C/SDA_D: J4.4, U34.4 (CHC), U34.7 (CHC); also elsewhere on the board
/I2C/SDA_E: J5.4, U37.4 (CHC), U37.7 (CHC); also elsewhere on the board
/I2C/SDA_F: J6.4, U40.4 (CHC), U40.7 (CHC); also elsewhere on the board
/NA_HS1: J1.12, U16.5 (CHD), U16.6 (CHD); also elsewhere on the board
/NA_HS2: J1.13, U16.4 (CHC), U16.7 (CHC); also elsewhere on the board
/NA_HS3: J1.18, U16.2 (CHB), U16.9 (CHB); also elsewhere on the board
/NA_HS4: J1.19, U16.1 (CHA), U16.10 (CHA); also elsewhere on the board
/NB_HS1: J2.12, U20.5 (CHD), U20.6 (CHD); also elsewhere on the board
/NB_HS2: J2.13, U20.4 (CHC), U20.7 (CHC); also elsewhere on the board
/NB_HS3: J2.18, U20.2 (CHB), U20.9 (CHB); also elsewhere on the board
/NB_HS4: J2.19, U20.1 (CHA), U20.10 (CHA); also elsewhere on the board
/NC_HS1: J3.12, U29.5 (CHD), U29.6 (CHD); also elsewhere on the board
/NC_HS2: J3.13, U29.4 (CHC), U29.7 (CHC); also elsewhere on the board
/NC_HS3: J3.18, U29.2 (CHB), U29.9 (CHB); also elsewhere on the board
/NC_HS4: J3.19, U29.1 (CHA), U29.10 (CHA); also elsewhere on the board
/ND_HS1: J4.12, U36.5 (CHD), U36.6 (CHD); also elsewhere on the board
/ND_HS2: J4.13, U36.4 (CHC), U36.7 (CHC); also elsewhere on the board
/ND_HS3: J4.18, U36.2 (CHB), U36.9 (CHB); also elsewhere on the board
/ND_HS4: J4.19, U36.1 (CHA), U36.10 (CHA); also elsewhere on the board
/NE_HS1: J5.12, U39.5 (CHD), U39.6 (CHD); also elsewhere on the board
/NE_HS2: J5.13, U39.4 (CHC), U39.7 (CHC); also elsewhere on the board
/NE_HS3: J5.18, U39.2 (CHB), U39.9 (CHB); also elsewhere on the board
/NE_HS4: J5.19, U39.1 (CHA), U39.10 (CHA); also elsewhere on the board
/NF_HS1: J6.12, U42.5 (CHD), U42.6 (CHD); also elsewhere on the board
/NF_HS2: J6.13, U42.4 (CHC), U42.7 (CHC); also elsewhere on the board
/NF_HS3: J6.18, U42.2 (CHB), U42.9 (CHB); also elsewhere on the board
/NF_HS4: J6.19, U42.1 (CHA), U42.10 (CHA); also elsewhere on the board
/SFPs/A_LSEN: U8.4 (ON), U15.4
/SFPs/A_NDET: J1.6, R5.2, U18.1 (CHA), U18.10 (CHA)
/SFPs/B_LSEN: U9.4 (ON), U19.4
/SFPs/B_NDET: J2.6, R7.2, U22.1 (CHA), U22.10 (CHA)
/SFPs/C_LSEN: U10.4 (ON), U23.4
/SFPs/C_NDET: J3.6, R10.2, U28.1 (CHA), U28.10 (CHA)
/SFPs/D_LSEN: U11.4 (ON), U31.4
/SFPs/D_NDET: J4.6, R15.2, U35.1 (CHA), U35.10 (CHA)
/SFPs/E_LSEN: U12.4 (ON), U32.4
/SFPs/E_NDET: J5.6, R18.2, U38.1 (CHA), U38.10 (CHA)
/SFPs/F_LSEN: U13.4 (ON), U33.4
/SFPs/F_NDET: J6.6, R21.2, U41.1 (CHA), U41.10 (CHA)
/SFPs/PORTA_3V3: C10.1, J1.15, J1.16, U8.1 (OUT)
/SFPs/PORTB_3V3: C13.1, J2.15, J2.16, U9.1 (OUT)
/SFPs/PORTC_3V3: C15.1, J3.15, J3.16, U10.1 (OUT)
/SFPs/PORTD_3V3: C18.1, J4.15, J4.16, U11.1 (OUT)
/SFPs/PORTE_3V3: C20.1, J5.15, J5.16, U12.1 (OUT)
/SFPs/PORTF_3V3: C22.1, J6.15, J6.16, U13.1 (OUT)
GND: C10.2, C11.2, C12.2, C13.2, C14.2, C15.2, C17.2, C18.2, C19.2, C20.2, C21.2, C22.2, H1.1, H2.1, H3.1, H4.1, H5.1, H6.1, H7.1, H8.1, H9.1, H10.1, H11.1, H12.1, J1.1, J1.10, J1.11, J1.14, J1.17, J1.20, J2.1, J2.10, J2.11, J2.14, J2.17, J2.20, J3.1, J3.10, J3.11, J3.14, J3.17, J3.20, J4.1, J4.10, J4.11, J4.14, J4.17, J4.20, J5.1, J5.10, J5.11, J5.14, J5.17, J5.20, J6.1, J6.10, J6.11, J6.14, J6.17, J6.20, R3.2, R8.2, R11.2, R16.2, R19.2, R22.2, U8.2 (GND), U9.2 (GND), U10.2 (GND), U11.2 (GND), U12.2 (GND), U13.2 (GND), U15.3 (GND), U16.3 (GND), U16.8 (GND), U17.3 (GND), U17.8 (GND), U18.3 (GND), U18.8 (GND), U19.3 (GND), U20.3 (GND), U20.8 (GND), U21.3 (GND), U21.8 (GND), U22.3 (GND), U22.8 (GND), U23.3 (GND), U27.3 (GND), U27.8 (GND), U28.3 (GND), U28.8 (GND), U29.3 (GND), U29.8 (GND), U31.3 (GND), U32.3 (GND), U33.3 (GND), U34.3 (GND), U34.8 (GND), U35.3 (GND), U35.8 (GND), U36.3 (GND), U36.8 (GND), U37.3 (GND), U37.8 (GND), U38.3 (GND), U38.8 (GND), U39.3 (GND), U39.8 (GND), U40.3 (GND), U40.8 (GND), U41.3 (GND), U41.8 (GND), U42.3 (GND), U42.8 (GND); also elsewhere on the board
unnamed: R3.1, U8.3 (SET)
unnamed: R8.1, U9.3 (SET)
unnamed: R11.1, U10.3 (SET)
unnamed: R16.1, U11.3 (SET)
unnamed: R19.1, U12.3 (SET)
unnamed: R22.1, U13.3 (SET)

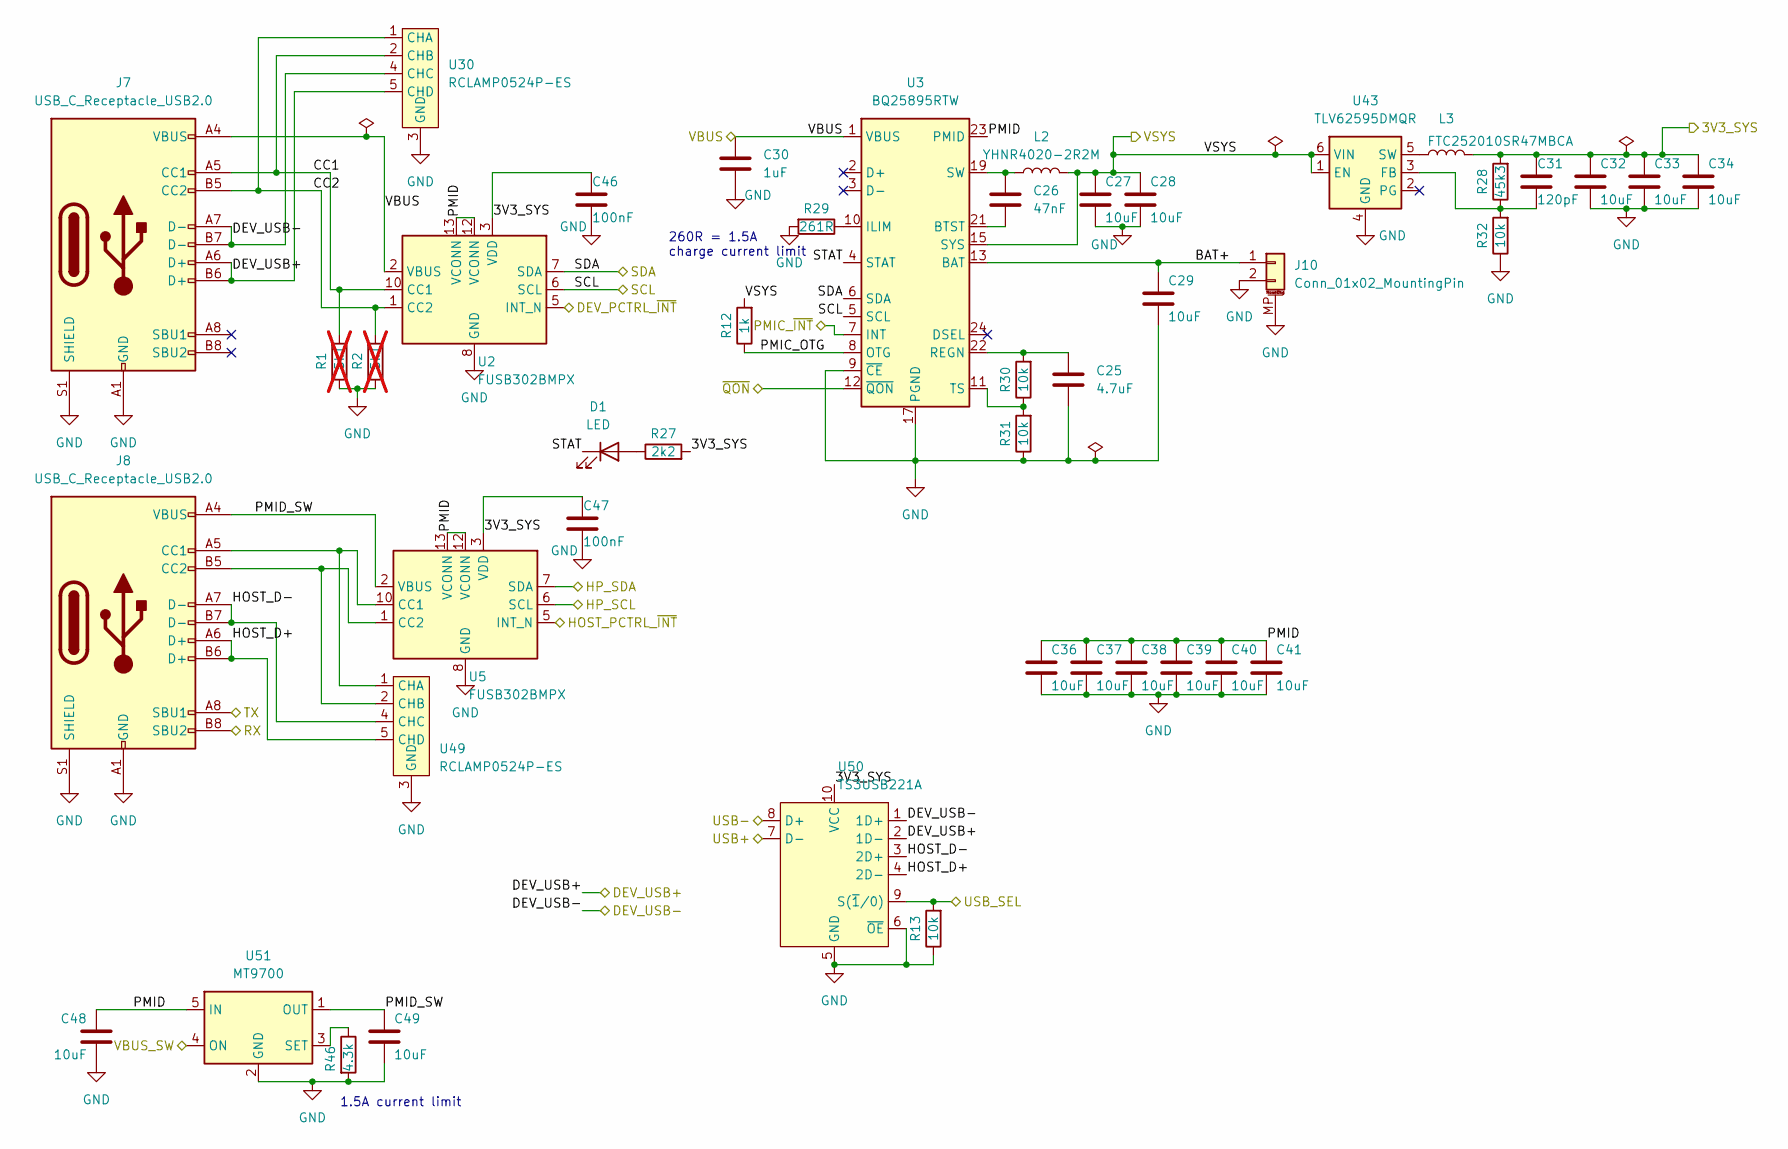
[picture p42: schematic usb.kicad_sch]

Parts:
C25: 4.7uF; C_0603_1608Metric
C26: 47nF; C_0402_1005Metric
C27, C28, C29, C32, C33, C34, C36, C37, C38, C39, C40, C41, C48, C49: 10uF; C_1206_3216Metric
C30: 1uF; C_0603_1608Metric
C31: 120pF; C_0402_1005Metric
C46, C47: 100nF; C_0402_1005Metric
D1: LED; LED_0603_1608Metric
J7, J8: USB_C_Receptacle_USB2.0; USB_C_Receptacle_SHOUHAN_TYPE-C_16P_CB1.6_073
J10: Conn_01x02_MountingPin; JST_PH_B2B-PH-SM4-TB_1x02-1MP_P2.00mm_Vertical
L2: YHNR4020-2R2M; L_Wurth_WE-LQSH-4020
L3: FTC252010SR47MBCA; L_Wurth_WE-LQSH-2512
R1, R2: 5k1; R_0402_1005Metric; not fitted
R12: 1k; R_0402_1005Metric
R13, R30, R31, R32: 10k; R_0402_1005Metric
R27: 2k2; R_0402_1005Metric
R28: 45k3; R_0402_1005Metric
R29: 261R; R_0402_1005Metric
R46: 4.3k; R_0402_1005Metric
U2, U5: FUSB302BMPX; WQFN-14-1EP_2.5x2.5mm_P0.5mm_EP1.45x1.45mm
U3: BQ25895RTW; Texas_S-PWQFN-N24_EP2.7x2.7mm_ThermalVias
U30, U49: RCLAMP0524P-ES; Diodes_UDFN-10_1.0x2.5mm_P0.5mm
U43: TLV62595DMQR; Texas_VSON-HR-6_1.5x1.5mm_P0.5mm
U50: TS3USB221A; Texas_PUQFN-10_RSE_1.5x2mm
U51: MT9700; SOT-23-5

Connections:
3V3_SYS: C31.1, C32.1, C33.1, C34.1, C46.1, C47.1, L3.2, R27.2, R28.2, U2.3 (VDD), U2.4 (VDD), U5.3 (VDD), U5.4 (VDD), U50.10 (VCC); also elsewhere on the board
/DEV_USB+: J7.A6 (D+), J7.B6 (D+), U30.5 (CHD), U30.6 (CHD), U50.2 (1D-); also elsewhere on the board
/DEV_USB-: J7.A7 (D-), J7.B7 (D-), U30.4 (CHC), U30.7 (CHC), U50.1 (1D+); also elsewhere on the board
/SCL_SYS: U2.6 (SCL), U3.5 (SCL); also elsewhere on the board
/SCL_TOP: U5.6 (SCL); also elsewhere on the board
/SDA_SYS: U2.7 (SDA), U3.6 (SDA); also elsewhere on the board
/SDA_TOP: U5.7 (SDA); also elsewhere on the board
/USB+: U50.7 (D-); also elsewhere on the board
/USB-: U50.8 (D+); also elsewhere on the board
/USB/BAT+: C29.1, J10.1, U3.13 (BAT), U3.14 (BAT)
/USB/CC1: J7.A5 (CC1), R1.1, U2.10 (CC1), U2.11 (CC1), U30.2 (CHB), U30.9 (CHB)
/USB/CC2: J7.B5 (CC2), R2.1, U2.1 (CC2), U2.14 (CC2), U30.1 (CHA), U30.10 (CHA)
/USB/HOST_D+: J8.A6 (D+), J8.B6 (D+), U49.5 (CHD), U49.6 (CHD), U50.4 (2D-)
/USB/HOST_D-: J8.A7 (D-), J8.B7 (D-), U49.4 (CHC), U49.7 (CHC), U50.3 (2D+)
/USB/PMIC_OTG: R12.1, U3.8 (OTG)
/USB/PMID: C36.1, C37.1, C38.1, C39.1, C40.1, C41.1, C48.1, U2.12 (VCONN), U2.13 (VCONN), U3.23 (PMID), U5.12 (VCONN), U5.13 (VCONN), U51.5 (IN)
/USB/PMID_SW: C49.1, J8.A4 (VBUS), J8.A9 (VBUS), J8.B4 (VBUS), J8.B9 (VBUS), U5.2 (VBUS), U51.1 (OUT)
/USB/RX: J8.B8 (SBU2); also elsewhere on the board
/USB/STAT: D1.1 (K), U3.4 (STAT)
/USB/TX: J8.A8 (SBU1); also elsewhere on the board
/USBSEL: R13.2, U50.9 (S(~1/0)); also elsewhere on the board
/VBUS: C30.1, J7.A4 (VBUS), J7.A9 (VBUS), J7.B4 (VBUS), J7.B9 (VBUS), U2.2 (VBUS), U3.1 (VBUS); also elsewhere on the board
/VBUS_SW: U51.4 (ON); also elsewhere on the board
/VSYS: C27.1, C28.1, L2.2, R12.2, U3.15 (SYS), U3.16 (SYS), U43.1 (EN), U43.6 (VIN); also elsewhere on the board
/~INT_SYS: U2.5 (INT_N), U3.7 (INT), U5.5 (INT_N); also elsewhere on the board
/~QON: U3.12 (~QON); also elsewhere on the board
GND: C25.2, C27.2, C28.2, C29.2, C30.2, C32.2, C33.2, C34.2, C36.2, C37.2, C38.2, C39.2, C40.2, C41.2, C46.2, C47.2, C48.2, C49.2, J7.A1 (GND), J7.A12 (GND), J7.B1 (GND), J7.B12 (GND), J7.S1 (SHIELD), J8.A1 (GND), J8.A12 (GND), J8.B1 (GND), J8.B12 (GND), J8.S1 (SHIELD), J10.2, J10.MP (MountPin), R1.2, R2.2, R13.1, R29.2, R31.1, R32.1, R46.2, U2.8 (GND), U2.9 (GND), U2.15 (GND), U3.9 (~CE), U3.17 (PGND), U3.18 (PGND), U3.25 (PGND), U5.8 (GND), U5.9 (GND), U5.15 (GND), U30.3 (GND), U30.8 (GND), U43.4 (GND), U49.3 (GND), U49.8 (GND), U50.5 (GND), U50.6 (~OE), U51.2 (GND); also elsewhere on the board
unnamed: C26.1, L2.1, U3.19 (SW), U3.20 (SW)
unnamed: D1.2 (A), R27.1
unnamed: J8.A5 (CC1), U5.10 (CC1), U5.11 (CC1), U49.1 (CHA), U49.10 (CHA)
unnamed: J8.B5 (CC2), U5.1 (CC2), U5.14 (CC2), U49.2 (CHB), U49.9 (CHB)
unnamed: C26.2, U3.21 (BTST)
unnamed: R29.1, U3.10 (ILIM)
unnamed: C25.1, R30.2, U3.22 (REGN)
unnamed: R30.1, R31.2, U3.11 (TS)
unnamed: C31.2, R28.1, R32.2, U43.3 (FB)
unnamed: L3.1, U43.5 (SW)
unnamed: R46.1, U51.3 (SET)

Notes on the sheet:
260R = 1.5A charge current limit
1.5A current limit

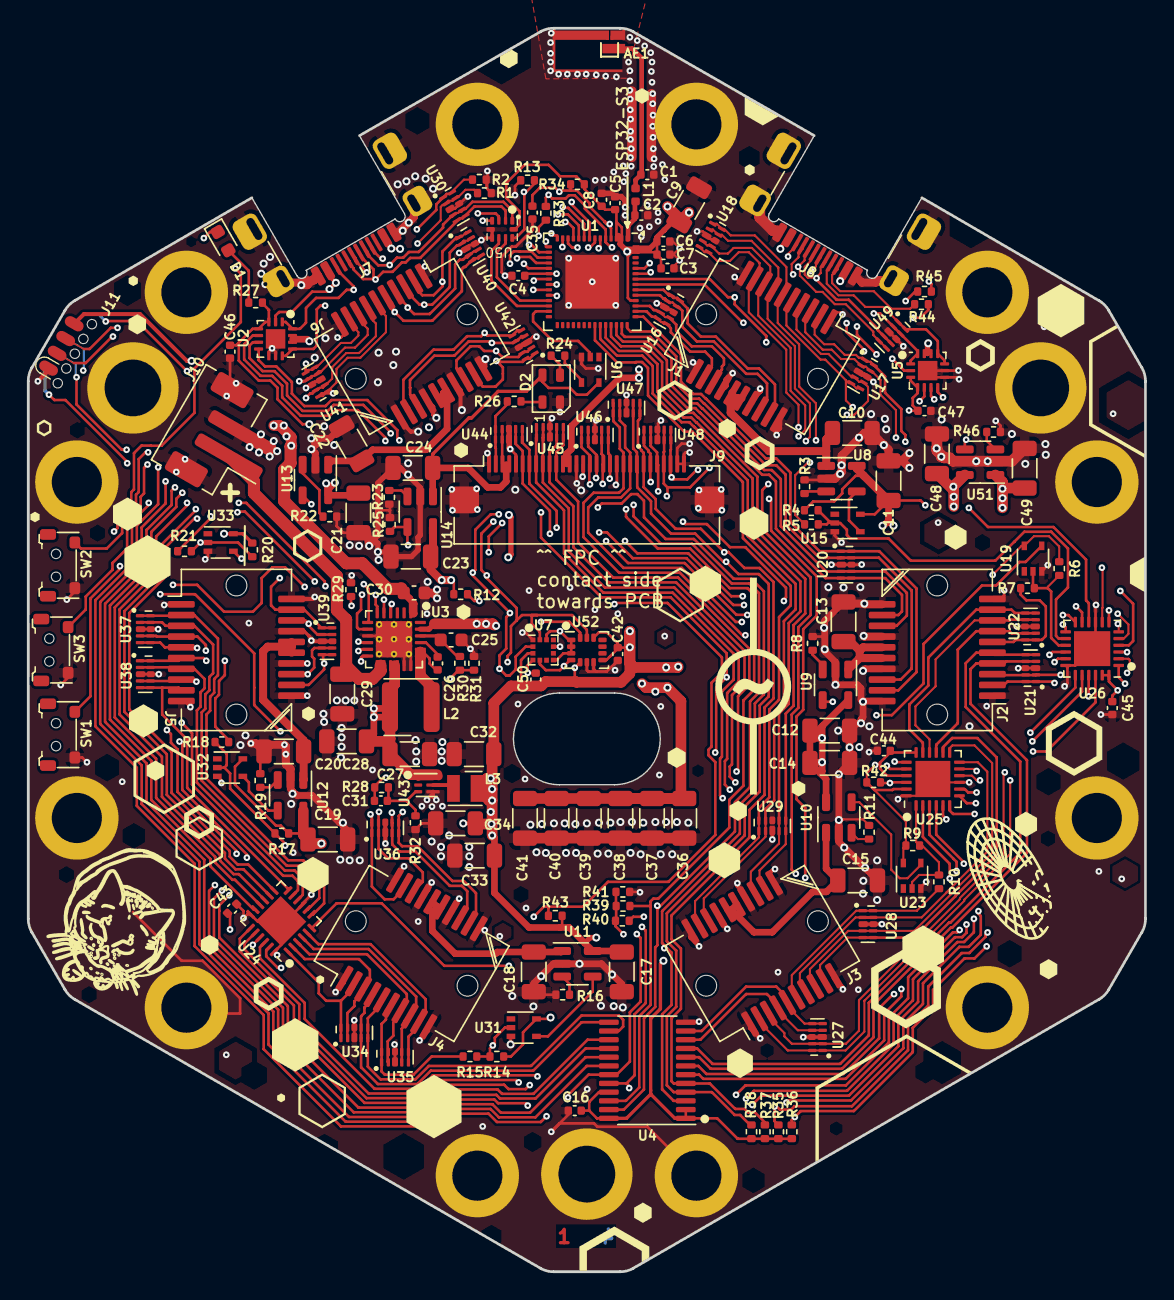
[picture p43: board tildagon-base.kicad_pcb from above]

Board: 4 copper layers, 83.1 x 92.5 mm, 183 parts (0 on the bottom side), 164 nets.
