emfcamp/badge-2024-hardware/hexpansion/hexpansion.kicad_pcb

## KiCad design hexpansion/hexpansion.kicad_pcb (2024-03-19)

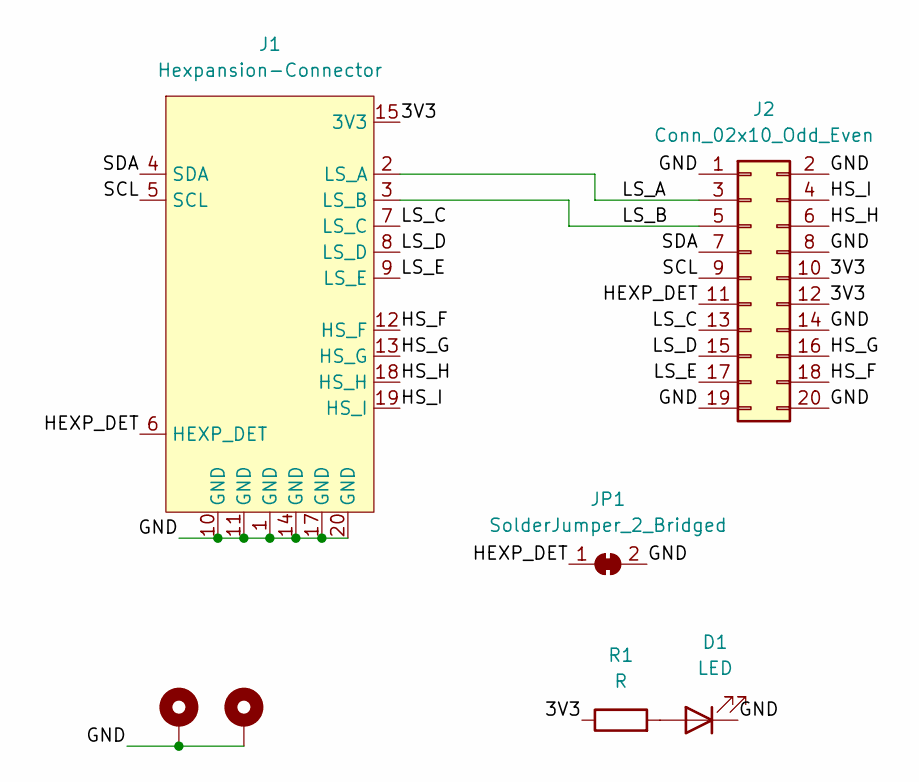
[picture p44: schematic hexpansion.kicad_sch]

Parts:
D1: LED; LED_0805_2012Metric
H1, H2: MountingHole_Pad; MountingHole_2.2mm_M2_Pad_Via
J1: Hexpansion-Connector; hexpansion-edge-connector
J2: Conn_02x10_Odd_Even; PinHeader_2x10_P2.54mm_Vertical
JP1: SolderJumper_2_Bridged; SolderJumper-2_P1.3mm_Bridged_RoundedPad1.0x1.5mm
R1: R; R_0603_1608Metric

Connections:
/3V3: J1.15 (3V3), J1.16 (3V3), J2.10, J2.12, R1.1
/GND: D1.1 (K), H1.1, H2.1, J1.1 (GND), J1.10 (GND), J1.11 (GND), J1.14 (GND), J1.17 (GND), J1.20 (GND), J2.1, J2.2, J2.8, J2.14, J2.19, J2.20, JP1.2 (B)
/HEXP_DET: J1.6 (HEXP_DET), J2.11, JP1.1 (A)
/HS_F: J1.12 (HS_F), J2.18
/HS_G: J1.13 (HS_G), J2.16
/HS_H: J1.18 (HS_H), J2.6
/HS_I: J1.19 (HS_I), J2.4
/LS_A: J1.2 (LS_A), J2.3
/LS_B: J1.3 (LS_B), J2.5
/LS_C: J1.7 (LS_C), J2.13
/LS_D: J1.8 (LS_D), J2.15
/LS_E: J1.9 (LS_E), J2.17
/SCL: J1.5 (SCL), J2.9
/SDA: J1.4 (SDA), J2.7
unnamed: D1.2 (A), R1.2

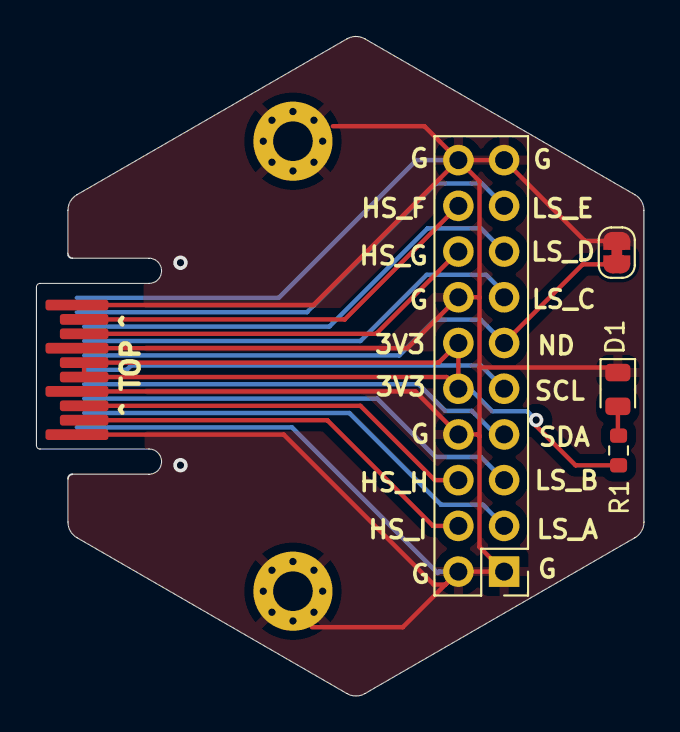
[picture p45: board hexpansion.kicad_pcb from above]

Board: 2 copper layers, 33.7 x 36.6 mm, 7 parts (0 on the bottom side), 15 nets.
