emfcamp/badge-2024-hardware/tildagon-base/tildagon-top.kicad_pcb

## KiCad design tildagon-base/tildagon-top.kicad_pcb (2024-03-15)

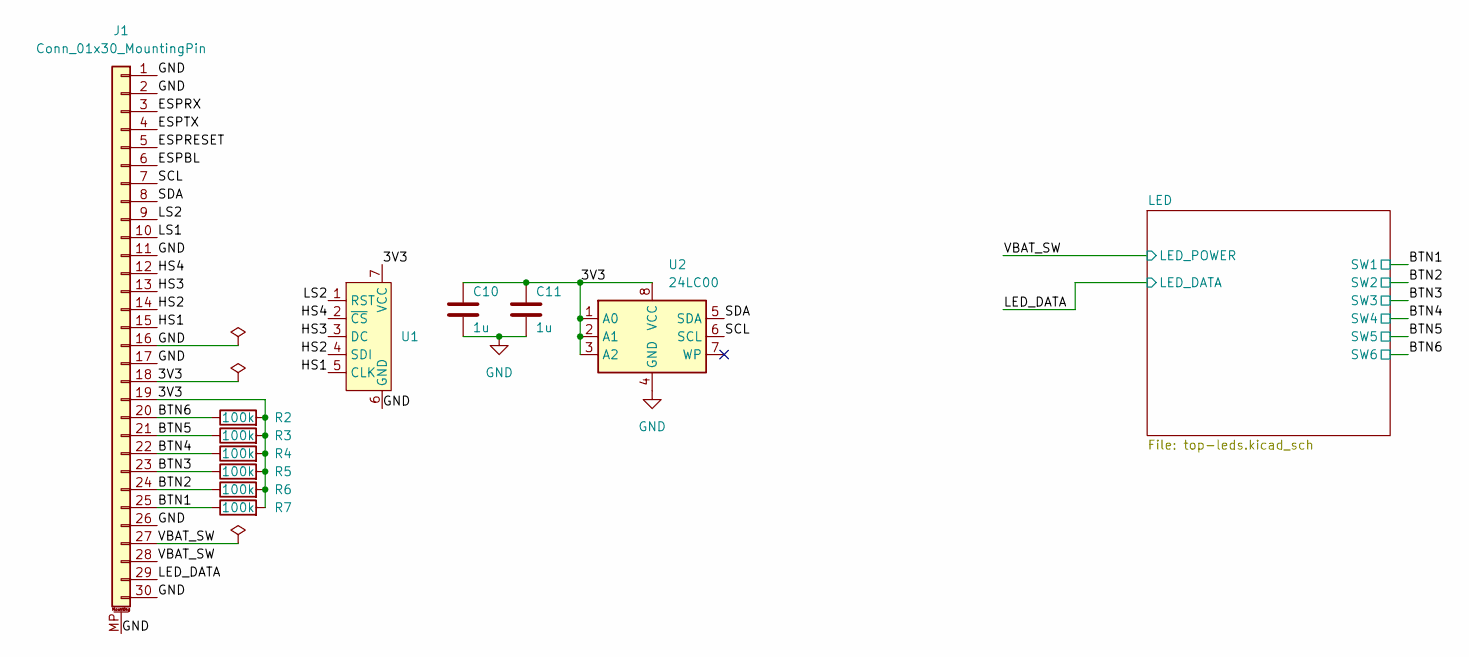
[picture p46: schematic tildagon-top.kicad_sch]

Parts:
C10, C11: 1u; C_0402_1005Metric
J1: Conn_01x30_MountingPin; Jushuo_AFC01-S30FCC-00_1x30-1MP_P0.50mm_Horizontal
R2, R3, R4, R5, R6, R7: 100k; R_0402_1005Metric
U1: PinHeader_1x07_P2.54mm_Vertical_LockPads
U2: 24LC00; TSSOP-8_4.4x3mm_P0.65mm

Connections:
/3V3: C10.1, C11.1, J1.18, J1.19, R2.2, R3.2, R4.2, R5.2, R6.2, R7.2, U1.7 (VCC), U2.1 (A0), U2.2 (A1), U2.3 (A2), U2.8 (VCC)
/BTN1: J1.25, R7.1; also elsewhere on the board
/BTN2: J1.24, R6.1; also elsewhere on the board
/BTN3: J1.23, R5.1; also elsewhere on the board
/BTN4: J1.22, R4.1; also elsewhere on the board
/BTN5: J1.21, R3.1; also elsewhere on the board
/BTN6: J1.20, R2.1; also elsewhere on the board
/ESPBL: J1.6
/ESPRESET: J1.5
/ESPRX: J1.3
/ESPTX: J1.4
/HS1: J1.15, U1.5 (CLK)
/HS2: J1.14, U1.4 (SDI)
/HS3: J1.13, U1.3 (DC)
/HS4: J1.12, U1.2 (~CS)
/LED_DATA: J1.29; also elsewhere on the board
/LS1: J1.10
/LS2: J1.9, U1.1 (RST)
/SCL: J1.7, U2.6 (SCL)
/SDA: J1.8, U2.5 (SDA)
/VBAT_SW: J1.27, J1.28; also elsewhere on the board
GND: C10.2, C11.2, J1.1, J1.2, J1.11, J1.16, J1.17, J1.26, J1.30, J1.MP (MountPin), U1.6 (GND), U2.4 (GND); also elsewhere on the board

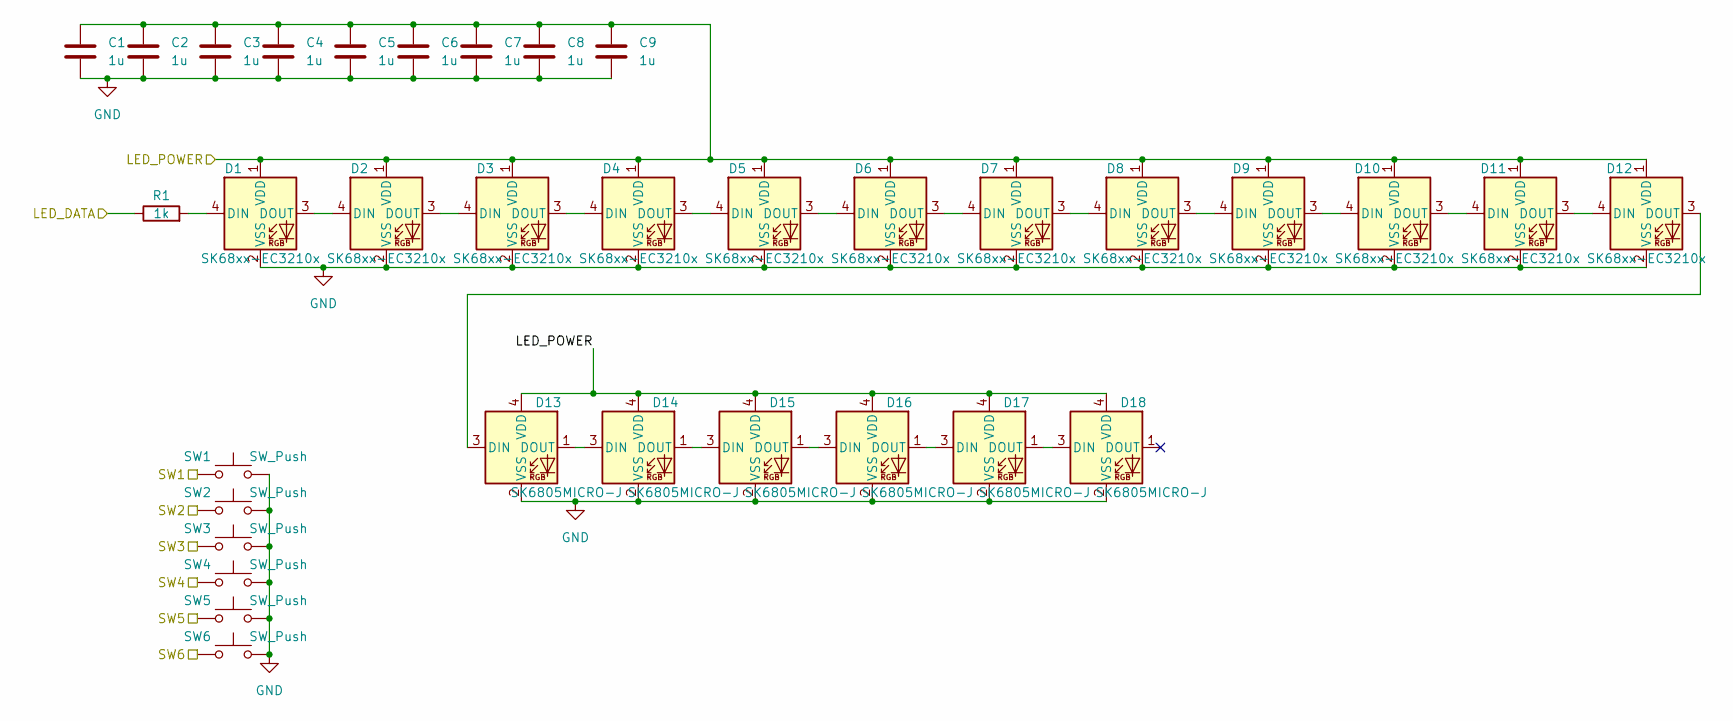
[picture p47: schematic top-leds.kicad_sch]

Parts:
C1, C2, C3, C4, C5, C6, C7, C8, C9: 1u; C_0402_1005Metric
D1, D2, D3, D4, D5, D6, D7, D8, D9, D10, D11, D12: SK68xx-EC3210x; SK6805SIDE-S
D13, D14, D15, D16, D17, D18: SK6805MICRO-J; LED_SK6805_PLCC4_2.4x2.7mm_P1.3mm
R1: 1k; R_0402_1005Metric
SW1, SW2, SW3, SW4, SW5, SW6: SW_Push; sidebutton-1TS003B-1400-3500A-CT

Connections:
/BTN1: SW1.1; also elsewhere on the board
/BTN2: SW2.1; also elsewhere on the board
/BTN3: SW3.1; also elsewhere on the board
/BTN4: SW4.1; also elsewhere on the board
/BTN5: SW5.1; also elsewhere on the board
/BTN6: SW6.1; also elsewhere on the board
/LED_DATA: R1.1; also elsewhere on the board
/VBAT_SW: C1.1, C2.1, C3.1, C4.1, C5.1, C6.1, C7.1, C8.1, C9.1, D1.1 (VDD), D2.1 (VDD), D3.1 (VDD), D4.1 (VDD), D5.1 (VDD), D6.1 (VDD), D7.1 (VDD), D8.1 (VDD), D9.1 (VDD), D10.1 (VDD), D11.1 (VDD), D12.1 (VDD), D13.4 (VDD), D14.4 (VDD), D15.4 (VDD), D16.4 (VDD), D17.4 (VDD), D18.4 (VDD); also elsewhere on the board
GND: C1.2, C2.2, C3.2, C4.2, C5.2, C6.2, C7.2, C8.2, C9.2, D1.2 (VSS), D2.2 (VSS), D3.2 (VSS), D4.2 (VSS), D5.2 (VSS), D6.2 (VSS), D7.2 (VSS), D8.2 (VSS), D9.2 (VSS), D10.2 (VSS), D11.2 (VSS), D12.2 (VSS), D13.2 (VSS), D14.2 (VSS), D15.2 (VSS), D16.2 (VSS), D17.2 (VSS), D18.2 (VSS), SW1.2, SW2.2, SW3.2, SW4.2, SW5.2, SW6.2; also elsewhere on the board
unnamed: D1.4 (DIN), R1.2
unnamed: D1.3 (DOUT), D2.4 (DIN)
unnamed: D2.3 (DOUT), D3.4 (DIN)
unnamed: D3.3 (DOUT), D4.4 (DIN)
unnamed: D4.3 (DOUT), D5.4 (DIN)
unnamed: D5.3 (DOUT), D6.4 (DIN)
unnamed: D6.3 (DOUT), D7.4 (DIN)
unnamed: D7.3 (DOUT), D8.4 (DIN)
unnamed: D8.3 (DOUT), D9.4 (DIN)
unnamed: D9.3 (DOUT), D10.4 (DIN)
unnamed: D10.3 (DOUT), D11.4 (DIN)
unnamed: D11.3 (DOUT), D12.4 (DIN)
unnamed: D12.3 (DOUT), D13.3 (DIN)
unnamed: D13.1 (DOUT), D14.3 (DIN)
unnamed: D14.1 (DOUT), D15.3 (DIN)
unnamed: D15.1 (DOUT), D16.3 (DIN)
unnamed: D16.1 (DOUT), D17.3 (DIN)
unnamed: D17.1 (DOUT), D18.3 (DIN)

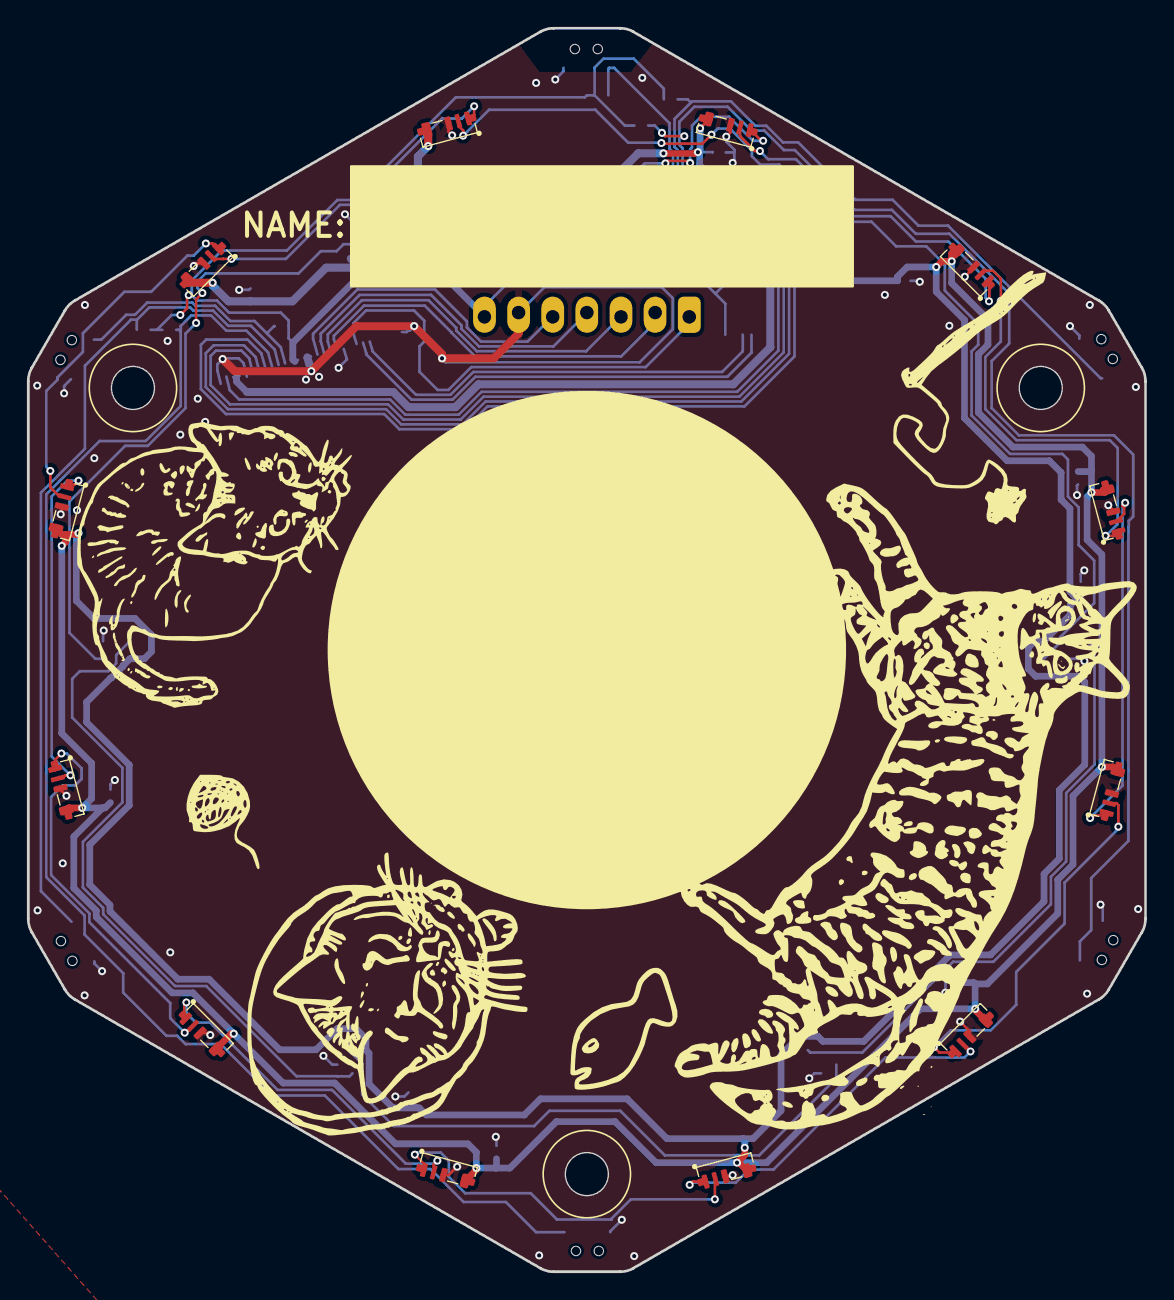
[picture p48: board tildagon-top.kicad_pcb from above]

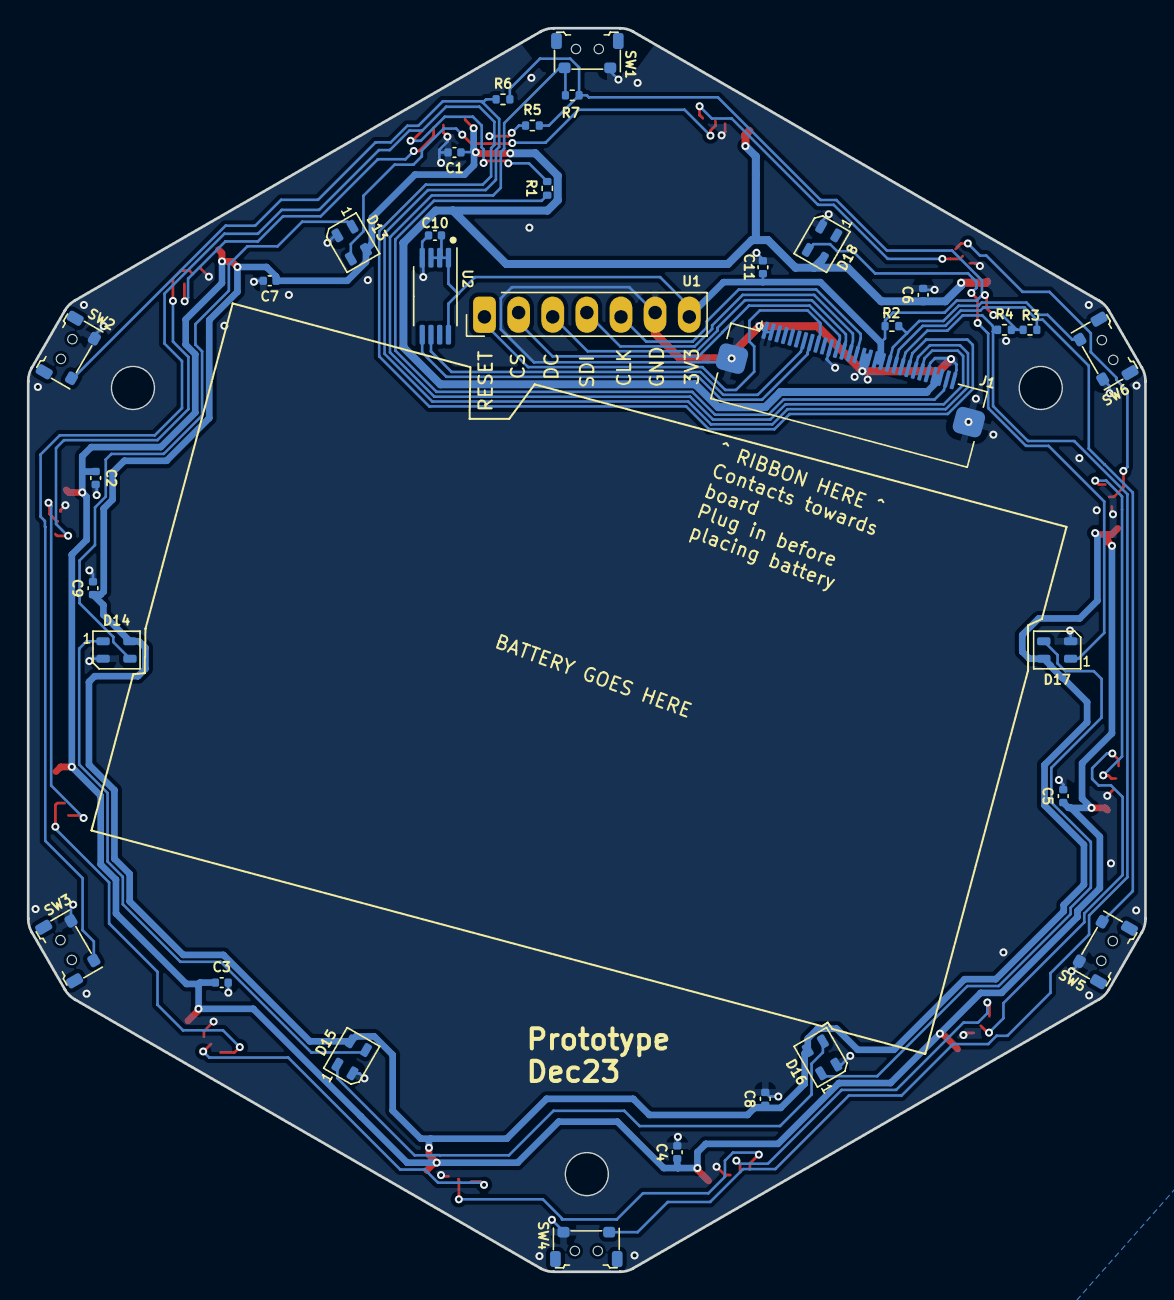
[picture p49: board tildagon-top.kicad_pcb from below]

Board: 2 copper layers, 83.1 x 92.5 mm, 45 parts (33 on the bottom side), 35 nets.
