emfcamp/badge-2024-hardware/(commit log)

2023-11-27 Add nodule PCB shape
    [nodule-shape.dxf, nodule.kicad_pcb, nodule.kicad_sch]
2023-11-28 more solderable standoffs, mid-mount USB
    [nodular-base.kicad_pcb, nodular-top.kicad_pcb]
2023-12-08 add WIP pin map and WIP BOM
    [pins-and-bom.ods]
2023-12-08 Update layout for top board, add library items
    [SK6805SIDE-S.step, nodular-base.FCStd, nodular-base.kicad_pcb, nodular-base.kicad_sch, nodular-top.kicad_pcb, nodular-top.kicad_sch, nodule.kicad_pcb, nodule.kicad_sch]
2023-12-09 Nodular-base: Add most components onto baseboard for a test fit. Nodular-base: Add fps and models for solderable standoffs, replace solderable standoffs and reposition them. Nodule template: Adjust n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
    [SMTSO.FCStd, SMTSO2030.step, SMTSO3030.step, base-can.kicad_sch, base-i2c.kicad_sch, bot-top-link.kicad_sch, gpio-mux.kicad_sch, hexM3x8+3.step]
2023-12-12 WIP layout for base
    [base-can.kicad_sch, base-i2c.kicad_sch, bot-top-link.kicad_sch, gpio-mux.kicad_sch, nodular-base.kicad_pcb, nodular-base.kicad_sch, pins-and-bom.ods, sfps.kicad_sch]
2023-12-13 Switched from CAN to USB for second USB-C port Added second PD controller and USB mux to allow switching between host and device port Added SOICbite to corner All routing complete Updated pin map, ad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
    [base-i2c.kicad_sch, bot-top-link.kicad_sch, gpio-mux.kicad_sch, nodular-base.kicad_pcb, nodular-base.kicad_sch, pins-and-bom.ods, usb.kicad_sch]
2023-12-13 Add hole Add decoupling caps, pullups, and voltage dividers Set current limit on PMIC Determine battery attachment angle Update BOM and pinouts
    [base-i2c.kicad_sch, gpio-mux.kicad_sch, nodular-base.kicad_pcb, nodular-base.kicad_sch, nodular-top.kicad_pcb, nodular-top.kicad_sch, pins-and-bom.ods, usb.kicad_sch]
2023-12-13 Add VCONN support and load switch with 1.5A current limit on host port Add accelerometer interrupt connection Update BOM with important capacitor and inductor PNs and costings
    [base-i2c.kicad_sch, bot-top-link.kicad_sch, gpio-mux.kicad_sch, nodular-base.kicad_pcb, nodular-base.kicad_sch, pins-and-bom.ods, sfps.kicad_sch, usb.kicad_sch]
2023-12-13 Add 3d models and fix erc errors
    [24AT07A0100.step, B2B-PH-SM4-TB.step, PUQFN-10.step, SK6805MICRO-J.step, SMTSO.FCStd, UFDN-10.step, bot-top-link.kicad_sch, hexM3x10+3.step]
2023-12-13 Increase width of high current traces, make antenna trace closer to 50 ohm, add vias to sides of antenna trace
    [nodular-base.kicad_pcb]
2023-12-13 Add guesstimate for unsponsored PCB cost to costings file
    [pins-and-bom.ods]
2023-12-14 Add eeprom and complete top electrical connections
    [nodular-top.kicad_pcb, nodular-top.kicad_sch]
2023-12-14 Add labels to baseboard
    [nodular-base.kicad_pcb]
2023-12-15 Add additional accelerometer-gyro option, update pin and address map, fix some ERC errors
    [base-i2c.kicad_sch, gpio-mux.kicad_sch, nodular-base.kicad_pcb, nodular-base.kicad_sch, pins-and-bom.ods, usb.kicad_sch]
2023-12-16 Implement review comments: extend zone keepout near PMIC
    [nodular-base.kicad_pcb]
2023-12-18 Optimize some via entries
    [nodular-base.kicad_pcb]
2023-12-27 Add baseline art (bart), add stencil alignment holes, complete BOM, prepare for proto order
    [nodular-base.kicad_sch, nodular-top.kicad_pcb, nodule.kicad_pcb, pins-and-bom.ods, usb.kicad_sch]
2024-02-14 Update nodule shape
    [nodule.kicad_pcb, nodule.step]
2024-02-14 Modify base board: - Fix ESP32 strapping pins state - Remove 3/6 M3 standoffs - Change to LGA-style pads on ESP32 - Modify SFP mechanical pads to not be plated - Add larger mechanical pads with more 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
    [base-i2c.kicad_sch, bot-top-link.kicad_sch, gpio-mux.kicad_sch, nodular-base.kicad_sch, nodular-top.kicad_pcb, usb.kicad_sch]
2024-03-15 Update top board layout, rename libraries
    [nodular-base.kicad_sch, nodular-top.kicad_pcb, nodular-top.kicad_sch]
2024-03-15 Complete renames
    [1TS003B.step, 2169900003.stp, 24AT07A0100.step, B2B-PH-SM4-TB.step, PUQFN-10.step, SK6805MICRO-J.step, SK6805SIDE-S.step, SK68xx-EC3210F.step]
2024-03-18 Added closed polygon of hexpansion board as SVG
2024-03-19 Add dimensions and height restrictions to hexpansion template
    [hexpansion.kicad_pcb]
2024-03-21 Fix 3d model for USB, make pad connection solid for standoffs.
    [2169900003.stp, tildagon-top.kicad_pcb]
2024-05-04 hexpansion fp-lib-table reference fix
    Looks like the footprint and symbols libraries got mixed up at some point?
2024-06-01 Final production design for emf2024
    [base-i2c.kicad_sch, bot-top-link.kicad_sch, gpio-mux.kicad_sch, sfps.kicad_sch, tildagon-base.kicad_sch, usb.kicad_sch]
2024-07-15 Add the missing PDF schematic export for the top board
2026-07-23 Re-save tildagon projects in KiCad v9
    [tildagon-base.kicad_pcb]
2026-07-23 Update base schematic files to 2026 version, regenerate PDF Update hexpansion project file version to fix trace visibility
    [base-can.kicad_sch, base-i2c.kicad_sch, bot-top-link.kicad_sch, gpio-mux.kicad_sch, sfps.kicad_sch, tildagon-base.kicad_pcb, tildagon-base.kicad_sch, usb.kicad_sch]
2026-07-23 Final 2026 Spaceagon artwork
    [SK6805MICRO-J.step, SK6805SIDE-S.step, TS-1101S-B-D-B-B-A.step, display.step, joystick.stp, tildagon-2026-mid.kicad_pcb, tildagon-2026-mid.kicad_sch, tildagon-2026-touch.kicad_pcb]
2026-07-23 Add PDF exports of midboard and touch board schematics
2026-07-23 Add spaceagon BOM file
    [spaceagon-bom.xlsx]
